profdc9/NiftyRobot/CAD/Front-Template.png

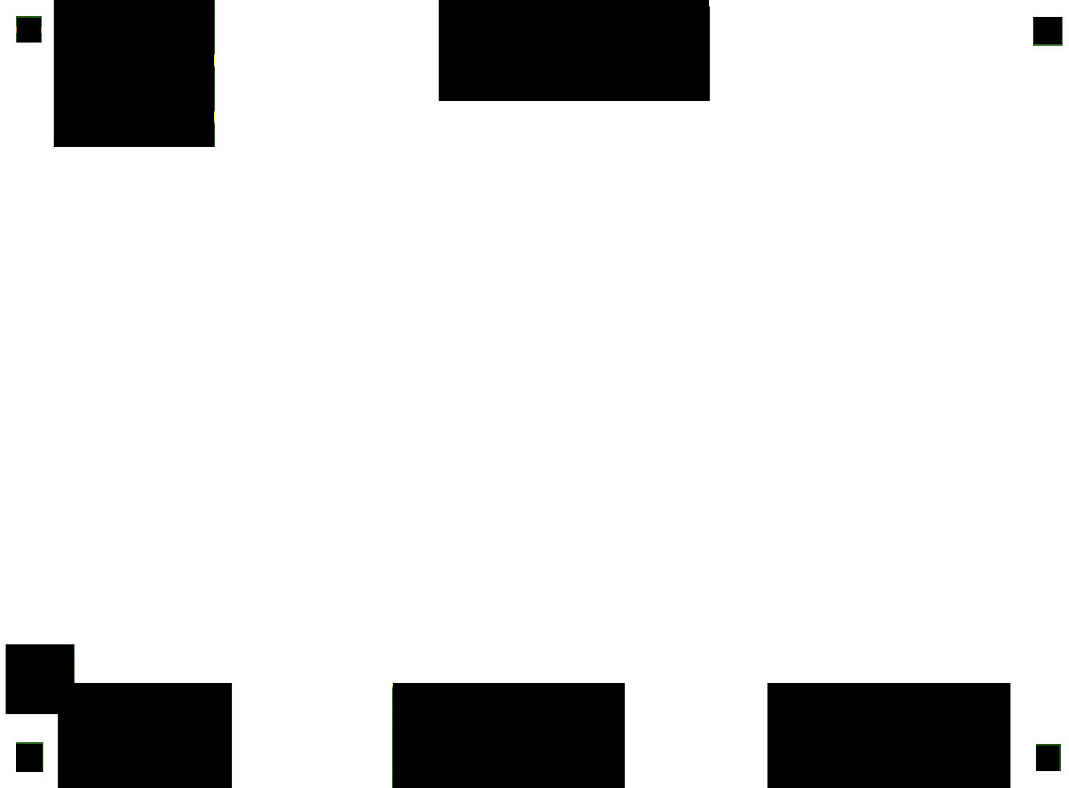
CAD/Front-Template.png
