profdc9/NiftyRobot/ControlBoard/ControlBoard-Back.png

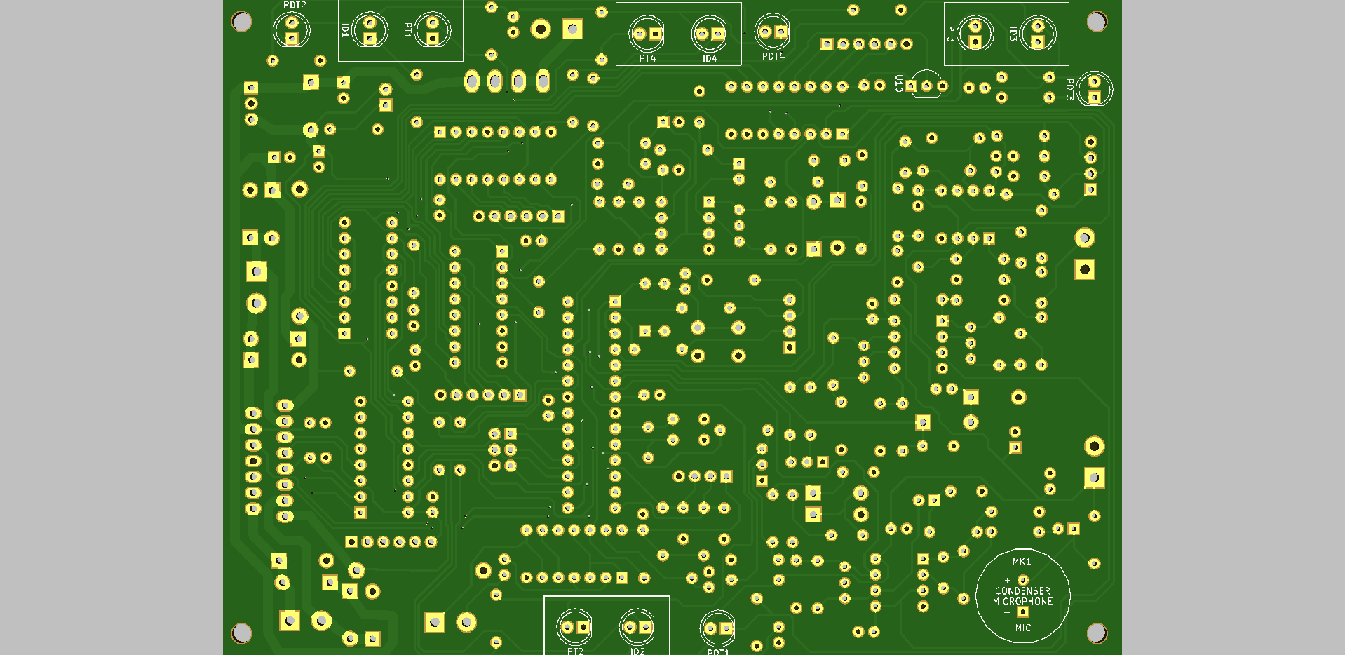
ControlBoard/ControlBoard-Back.png
