profdc9/NiftyRobot/ControlBoard/ControlBoard.png

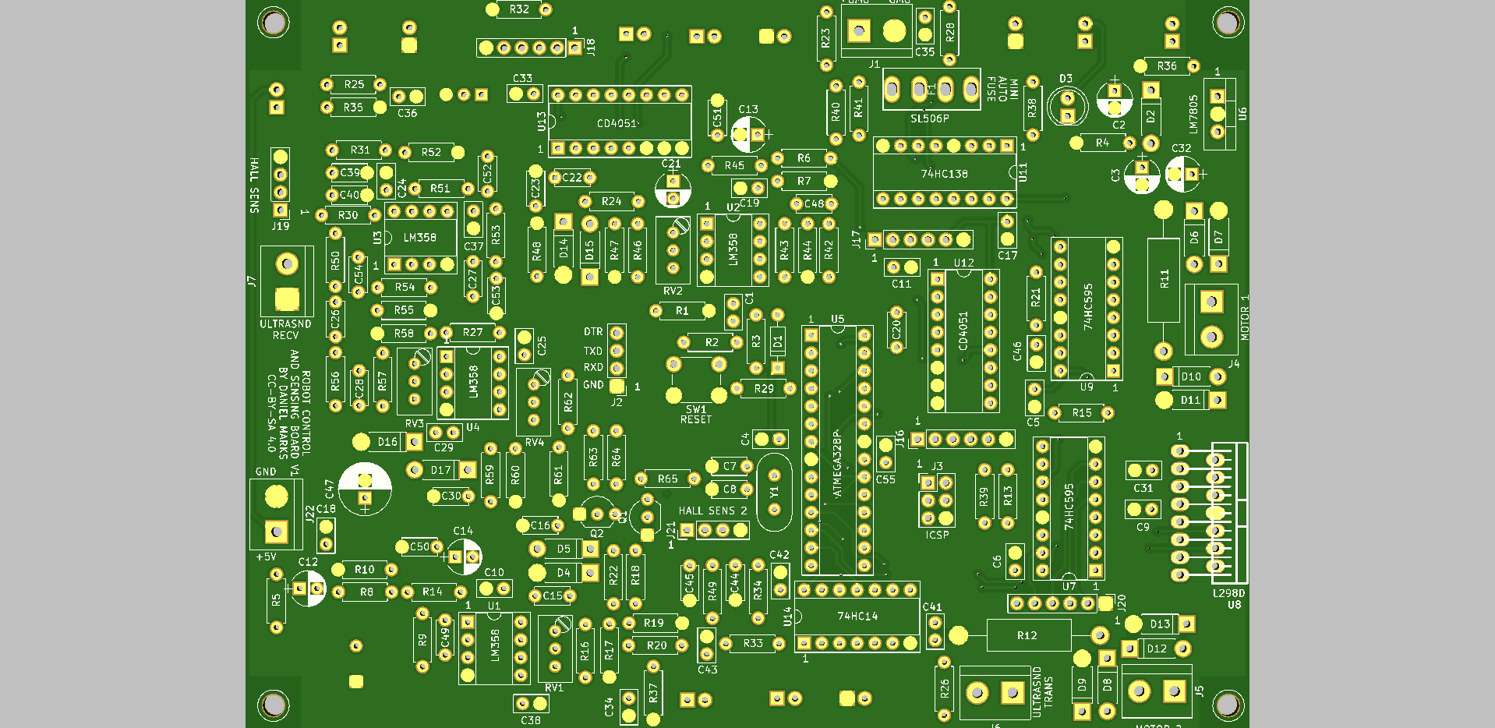
ControlBoard/ControlBoard.png
