profdc9/NiftyRobot/KeypadPI/KeypadPI-front.png

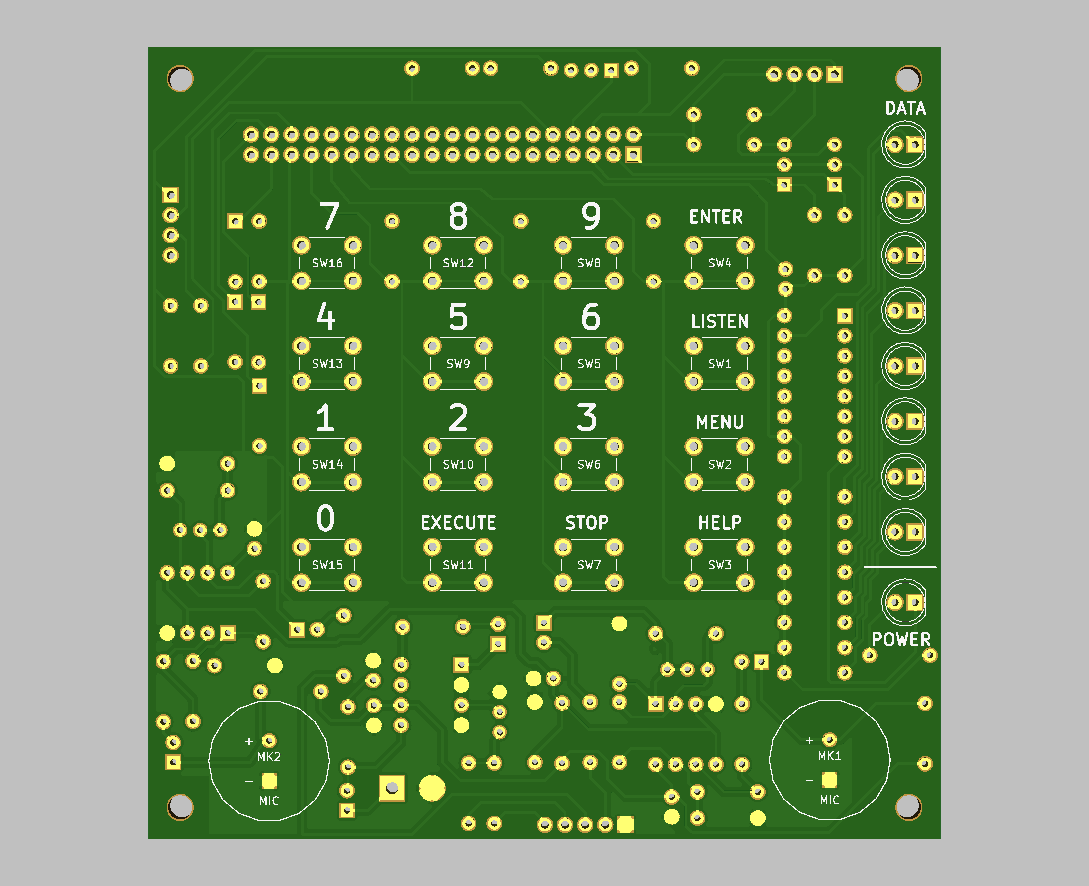
KeypadPI/KeypadPI-front.png
