profdc9/NiftyRobot/KeypadPI/KeypadPI.png

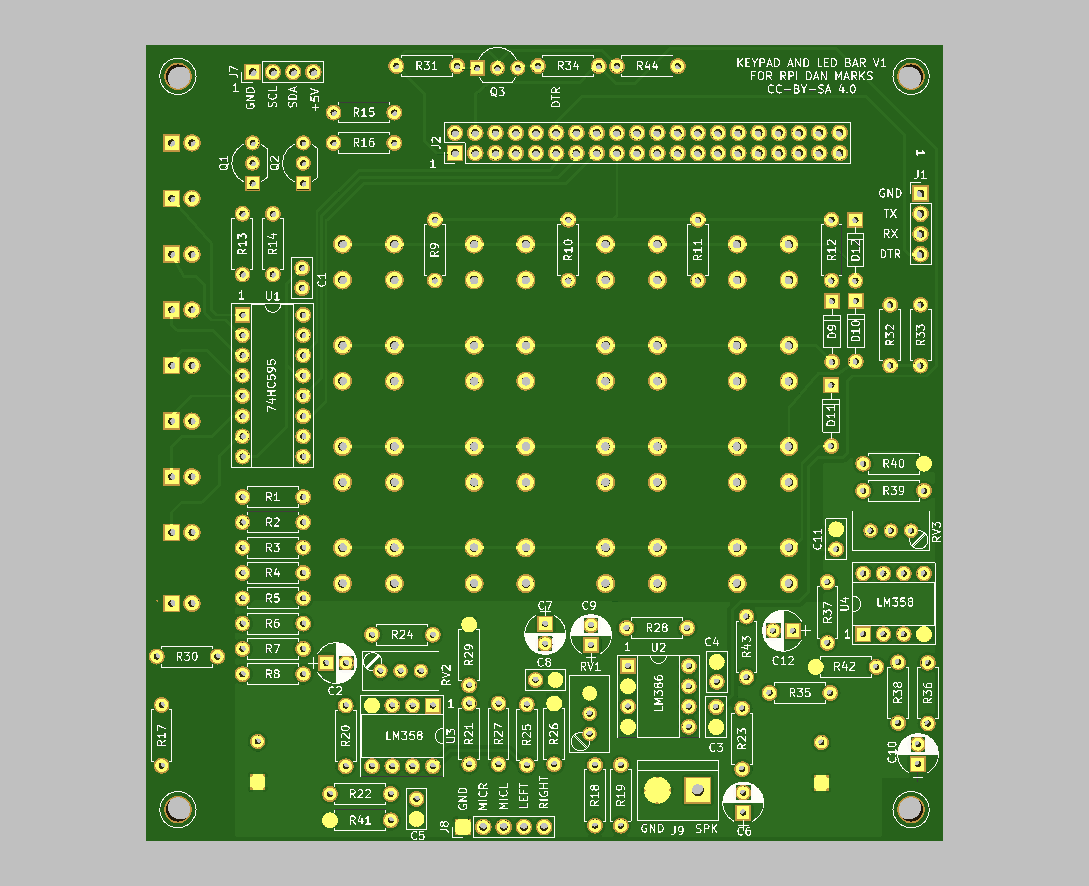
KeypadPI/KeypadPI.png
