profdc9/NiftyRobot/UltrasonicBoard/AdapterBoard.png

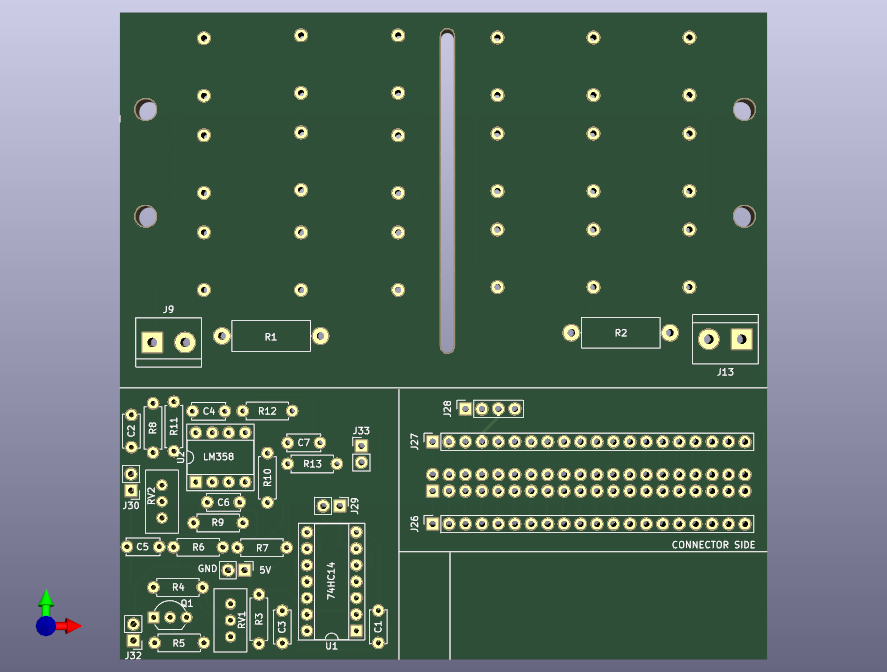
UltrasonicBoard/AdapterBoard.png
