profdc9/NiftyRobot/CAD/PCB_Bracket-TotalBracketBody.stl

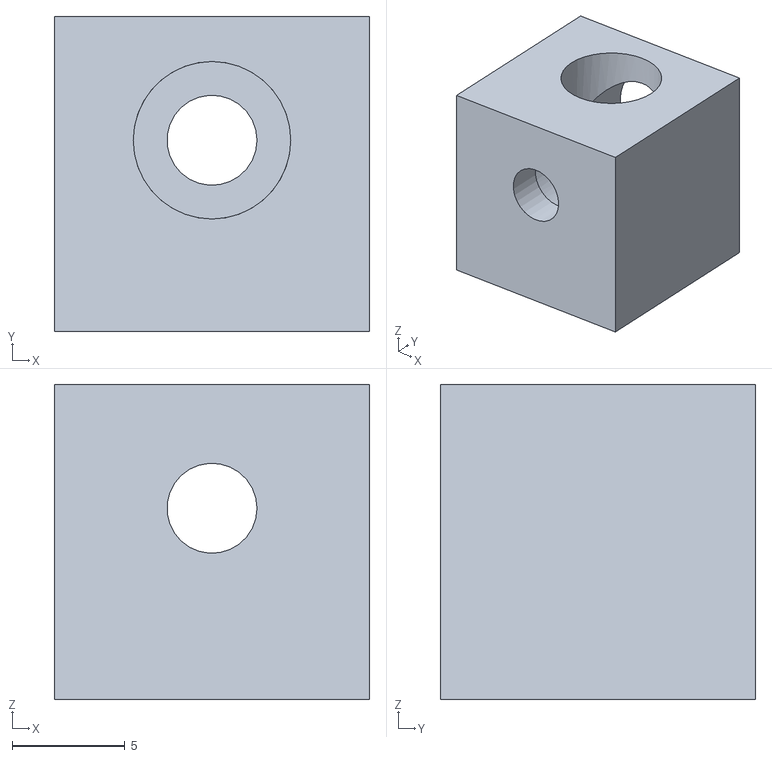
[picture p7: CAD file, 2021-11-20]
CAD/PCB_Bracket-TotalBracketBody.stl
14.0 x 14.0 x 14.0
