profdc9/NiftyRobot/CAD/Wheel-WholeWheel.stl

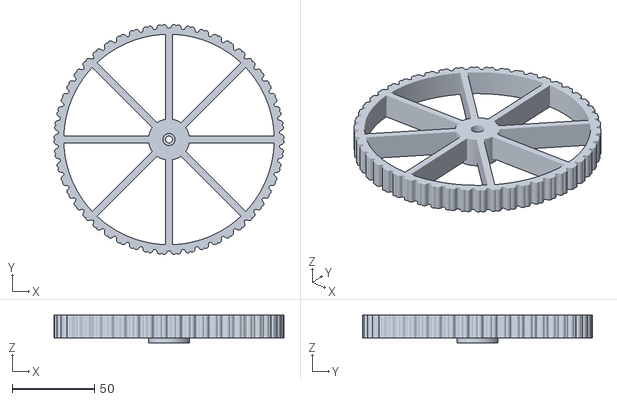
[picture p8: CAD file, 2021-11-20]
CAD/Wheel-WholeWheel.stl
139.9 x 139.8 x 17.0
