profdc9/NiftyRobot/CAD/Platform.FCStd

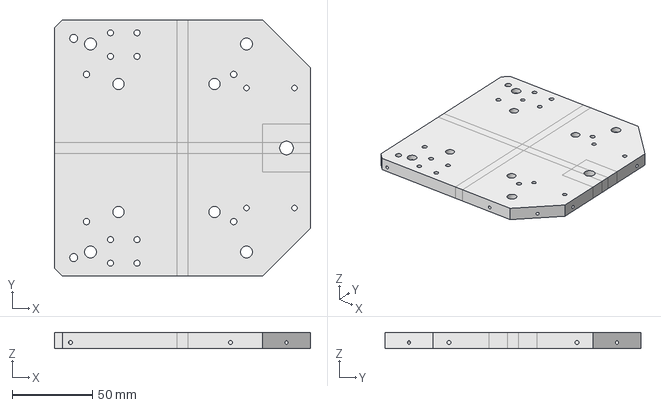
[picture p9: CAD file, 2021-11-20]
CAD/Platform.FCStd
160.0 x 160.0 x 10.0 mm
