profdc9/NiftyRobot/CAD/LeftSidePanel.FCStd

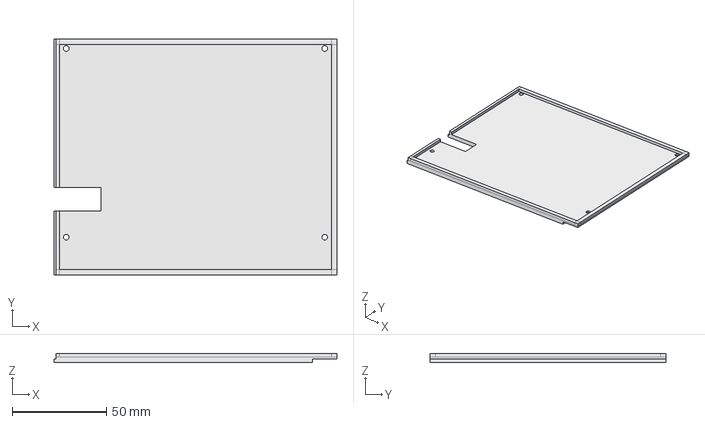
[picture p10: CAD file, 2021-11-20]
CAD/LeftSidePanel.FCStd
150.0 x 125.0 x 5.00 mm
