profdc9/NiftyRobot/CAD/FrontPanel-FrontSideBody.stl

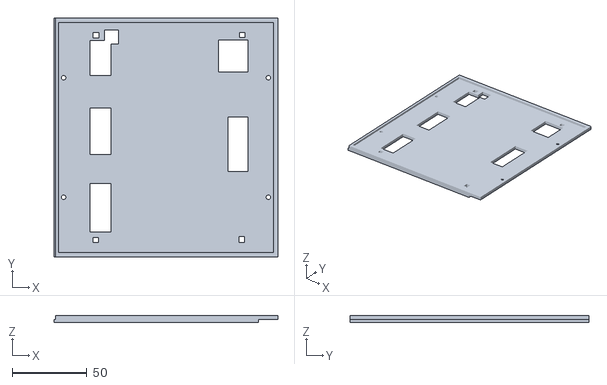
[picture p11: CAD file, 2021-10-10]
CAD/FrontPanel-FrontSideBody.stl
150.0 x 160.0 x 5.00
