profdc9/NiftyRobot/CAD/BackPanel.FCStd

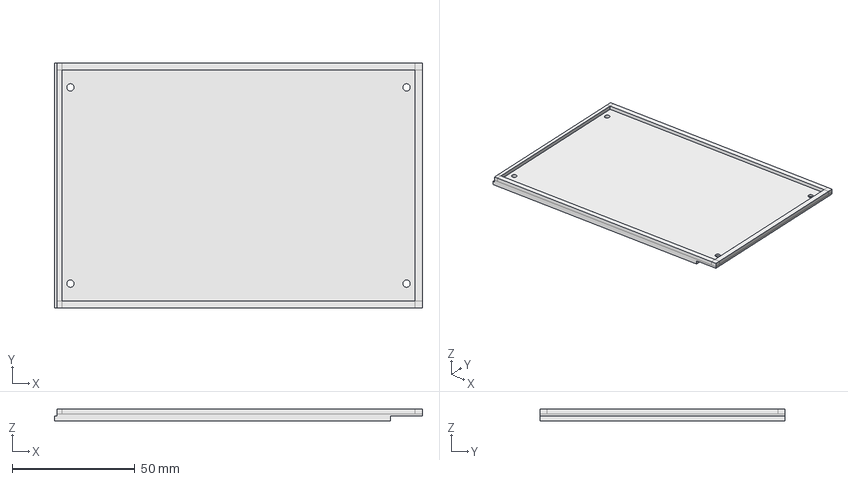
[picture p12: CAD file, 2021-10-10]
CAD/BackPanel.FCStd
150.0 x 100.0 x 5.00 mm
