profdc9/NiftyRobot/CAD/DiagonalLeftPanel-DiagonalLeftPanel.stl

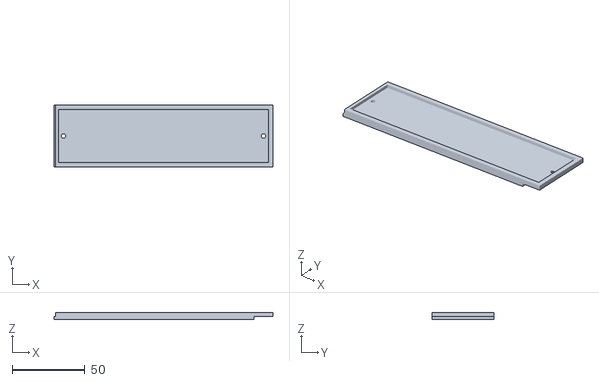
[picture p13: CAD file, 2021-10-10]
CAD/DiagonalLeftPanel-DiagonalLeftPanel.stl
150.0 x 42.4 x 5.00
