profdc9/NiftyRobot/CAD/FrontPanel2-FrontPanelTop2.stl

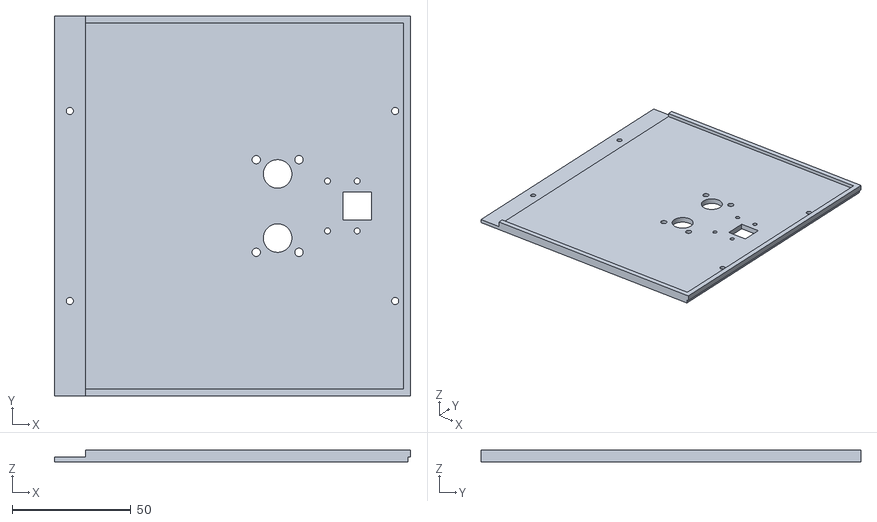
[picture p14: CAD file, 2021-10-10]
CAD/FrontPanel2-FrontPanelTop2.stl
150.0 x 160.0 x 5.00
