profdc9/NiftyRobot/CAD/RightSidePanel2.FCStd

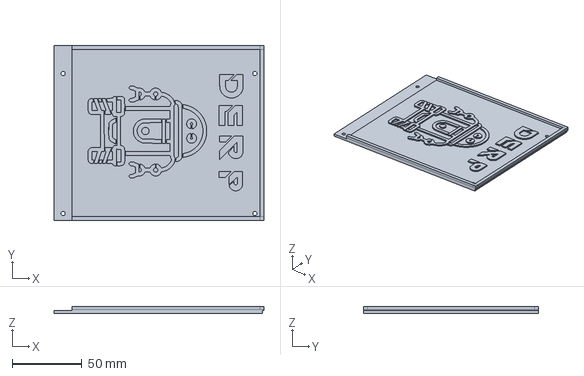
[picture p15: CAD file, 2021-10-10]
CAD/RightSidePanel2.FCStd
150.0 x 125.0 x 5.00 mm
