profdc9/NiftyRobot/CAD/FrontPanelUpper.FCStd

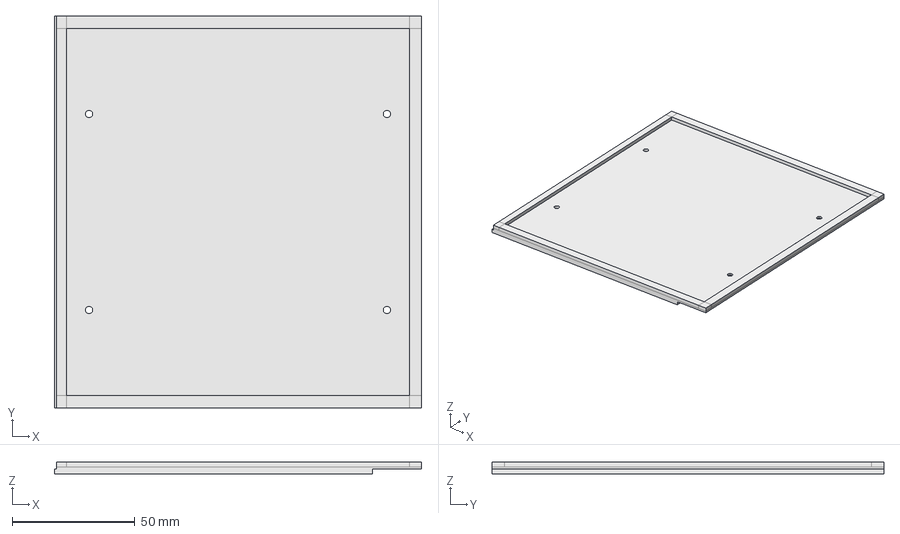
[picture p16: CAD file, 2021-10-10]
CAD/FrontPanelUpper.FCStd
150.0 x 160.0 x 5.00 mm
