profdc9/NiftyRobot/CAD/FrontPanel.FCStd

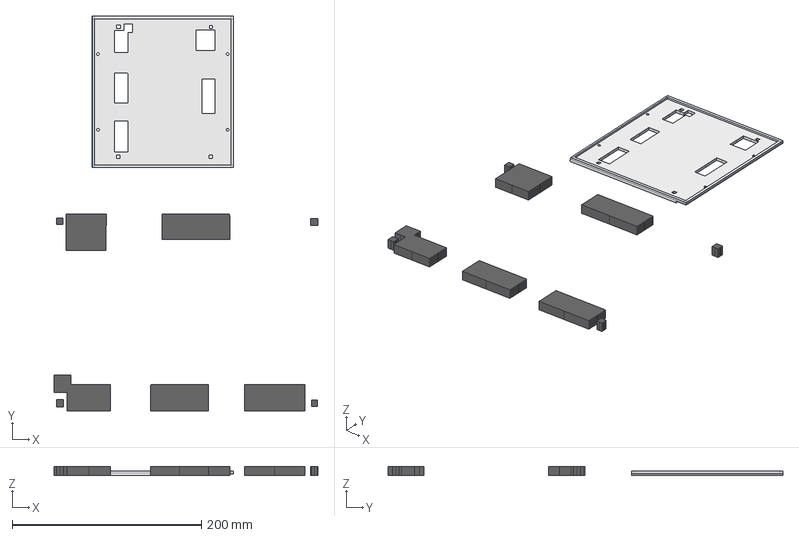
[picture p17: CAD file, 2021-10-10]
CAD/FrontPanel.FCStd
279.0 x 417.0 x 10.0 mm
HolesForBody
FrontPanelWithHoles
