profdc9/NiftyRobot/CAD/LEDPairHousingPart-UpDown.stl

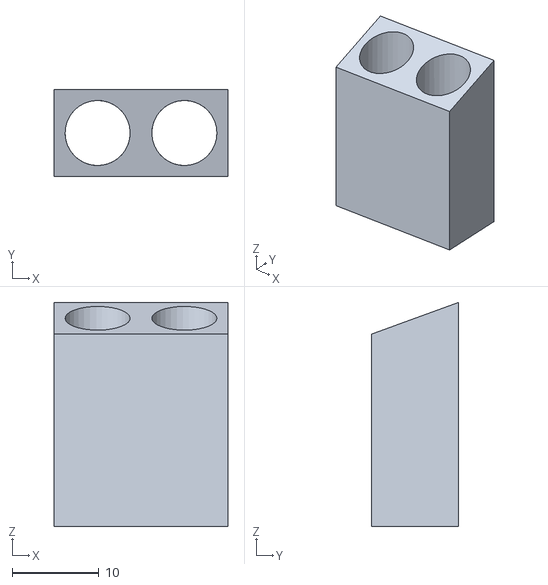
[picture p18: CAD file, 2021-09-24]
CAD/LEDPairHousingPart-UpDown.stl
20.0 x 10.0 x 25.8
