profdc9/NiftyRobot/CAD/LEDPairHousing.FCStd

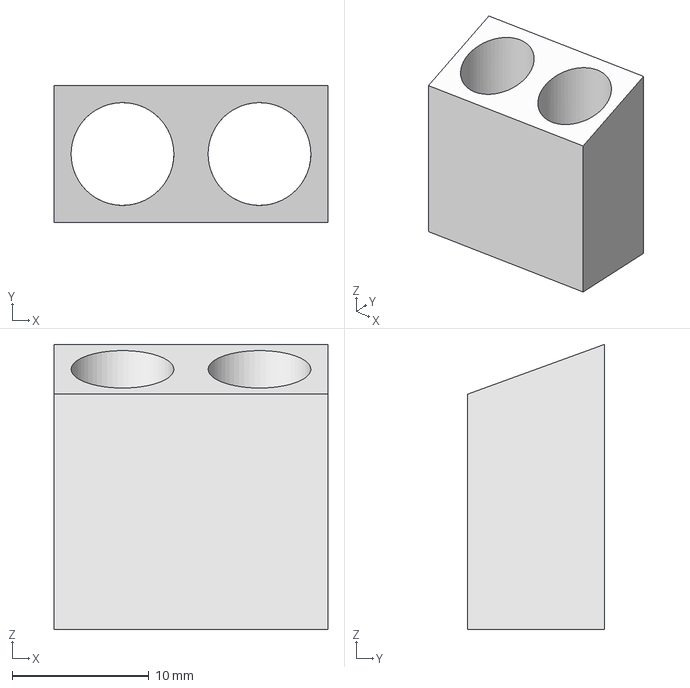
[picture p19: CAD file, 2021-09-24]
CAD/LEDPairHousing.FCStd
20.0 x 10.0 x 20.8 mm
