profdc9/NiftyRobot/CAD/LEDPairHousing-LeftRight.FCStd

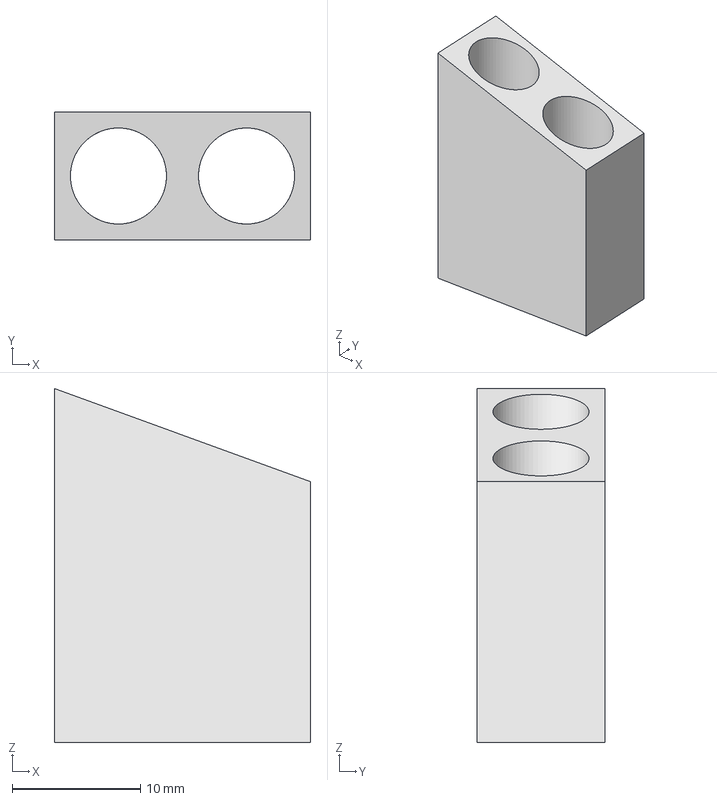
[picture p20: CAD file, 2021-09-24]
CAD/LEDPairHousing-LeftRight.FCStd
20.0 x 10.0 x 27.6 mm
