profdc9/NiftyRobot/(list of files, cad)

Other CAD files:
CAD/PCB_Bracket.FCStd
CAD/Platform-2nd3rd.FCStd
CAD/Platform-2nd3rd-RobotBase.stl
CAD/Platform-RobotBase.stl
CAD/LeftSidePanel-LeftSideBody.stl
CAD/RightSidePanel.FCStd
CAD/Wheel.FCStd
CAD/RightSidePanel-RightSideBody.stl
CAD/DiagonalLeftPanel2.stl
CAD/BackPanel2.FCStd
CAD/DiagonalRightPanel2.FCStd
CAD/BackPanel-BackPanelBody.stl
CAD/DiagonalRightPanel-DiagonalRightPanel.stl
CAD/DiagonalRightPanel.FCStd
CAD/FrontPanel2.FCStd
CAD/Platform - BeforeBase.FCStd
CAD/DiagonalLeftPanel.FCStd
CAD/LeftSidePanel2.FCStd
CAD/LEDPairHousingPart-LeftRight.stl
CAD/LEDPairHousing-UpDown.FCStd
CAD/BackPanel2.stl
CAD/DiagonalRightPanel2.stl
CAD/LeftSidePanel2.stl
CAD/RightSidePanel2.stl
