profdc9/NiftyRobot/UltrasonicBoard/AdapterBoard-Schematic.pdf

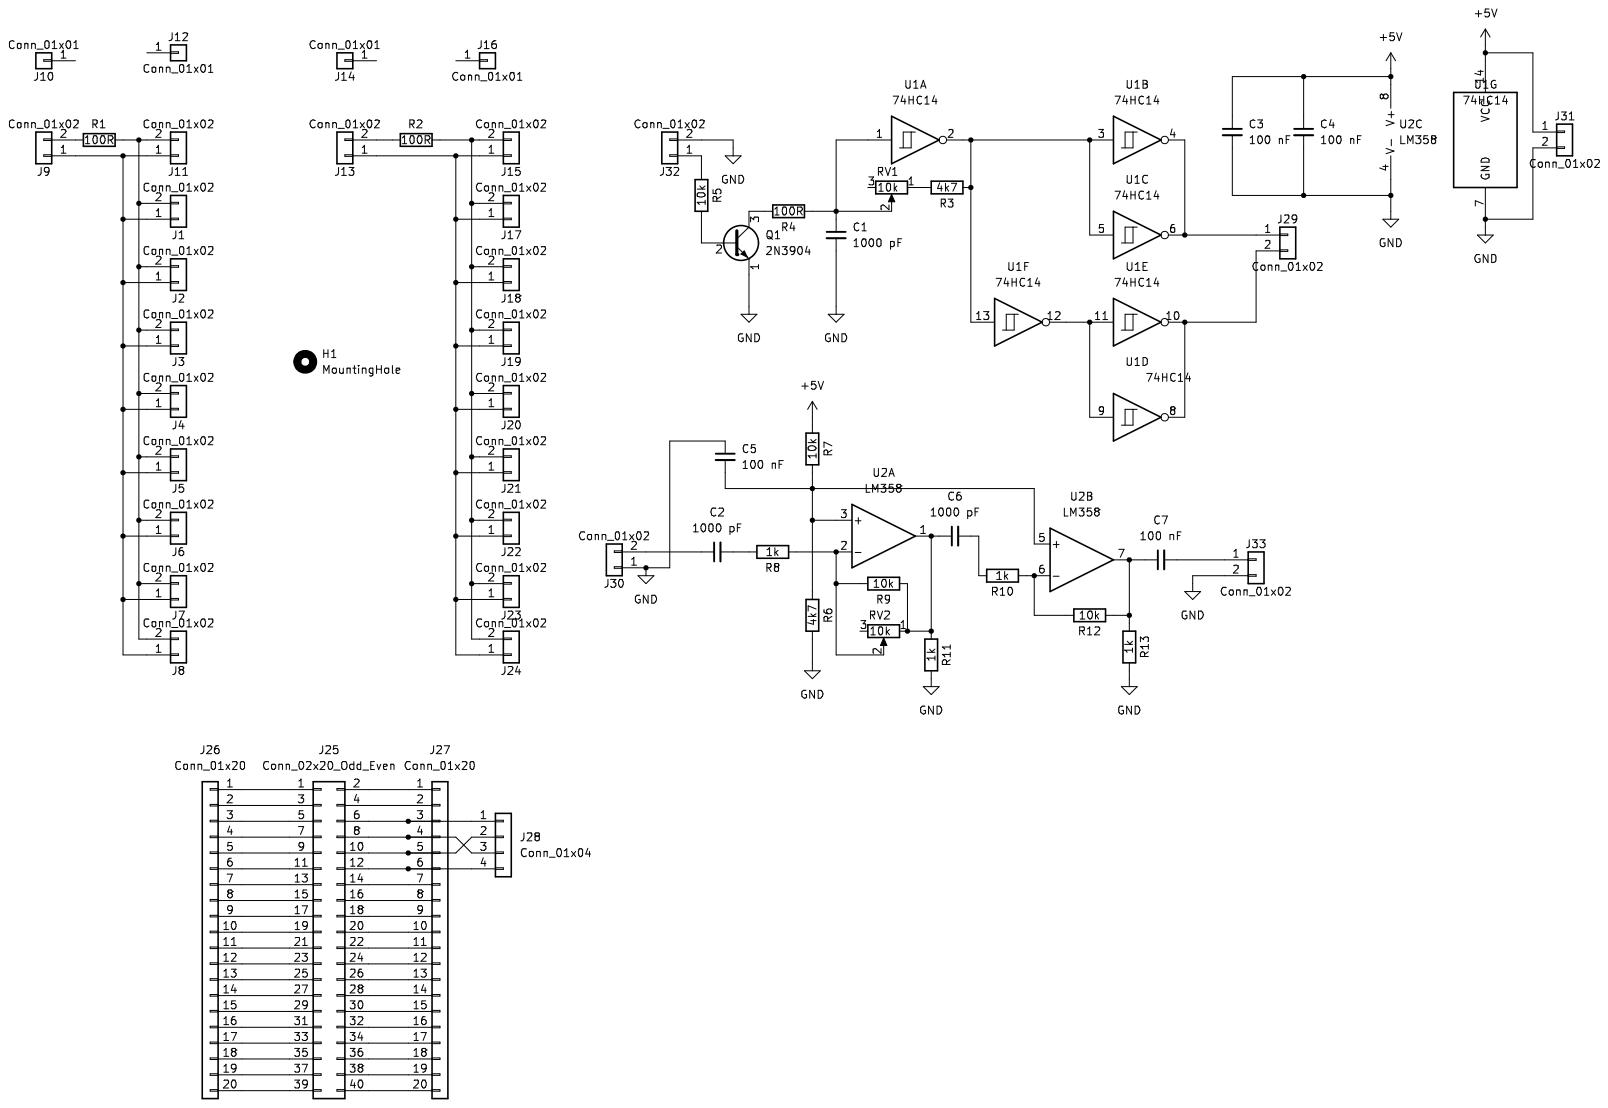
[picture p21: page 1]
