profdc9/NiftyRobot/KeypadPI/KeypadPI-schematic.pdf

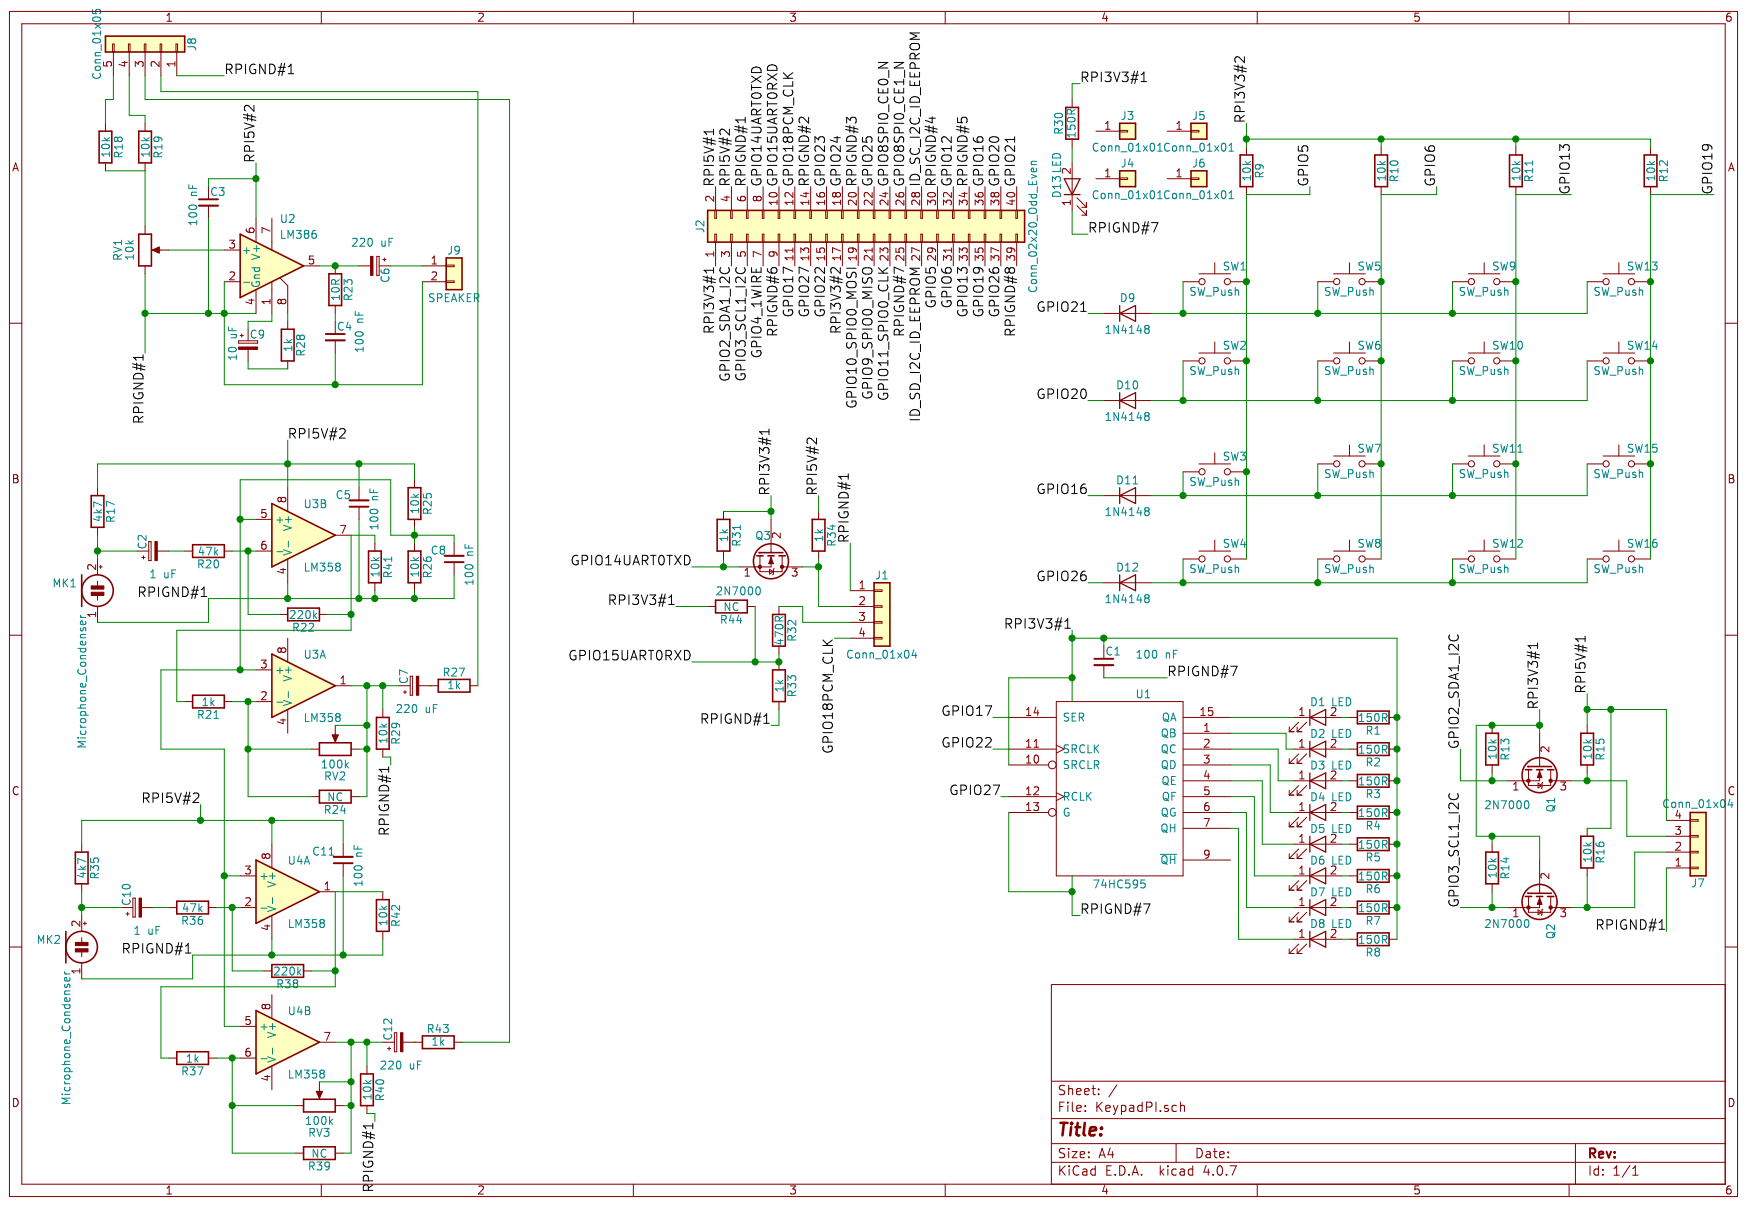
[picture p25: page 1]
