profdc9/NiftyRobot/UltrasonicBoard/AdapterBoard.kicad_pcb

## KiCad design UltrasonicBoard/AdapterBoard.kicad_pcb (2026-02-07)

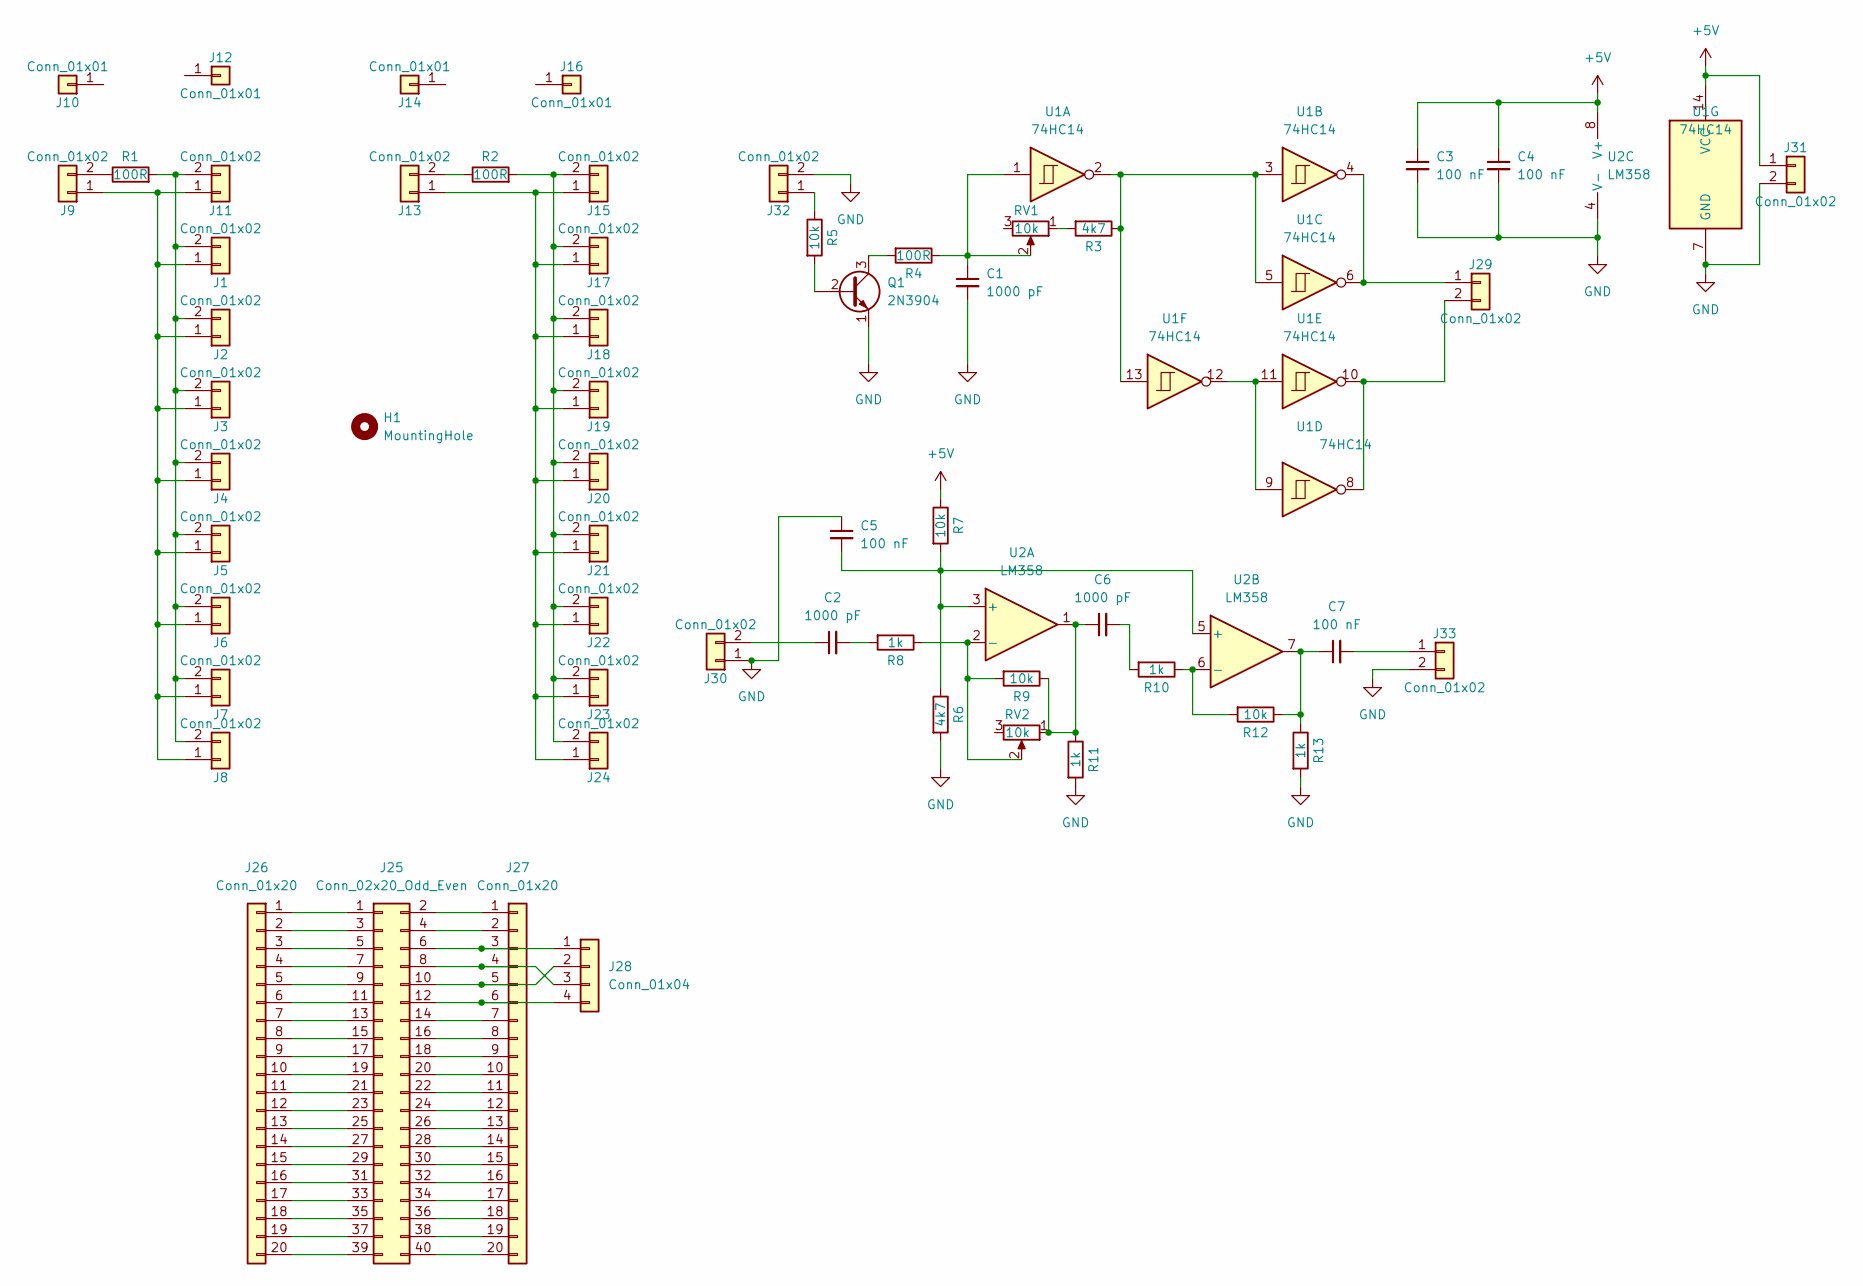
[picture p26: schematic AdapterBoard.kicad_sch]

Parts:
C1, C2, C6: 1000 pF; C_Disc_D5.0mm_W2.5mm_P5.00mm
C3, C4, C5, C7: 100 nF; C_Disc_D5.0mm_W2.5mm_P5.00mm
H1: MountingHole; BigSlotSeparator
J1, J2, J3, J4, J5, J6, J7, J8, J11, J15, J17, J18, J19, J20, J21, J22, J23, J24: Conn_01x02; UltrasoundTransceiver
J9, J13: Conn_01x02; TerminalBlock_bornier-2_P5.08mm
J10, J12, J14, J16: Conn_01x01; BlankMountingHole3.2
J25: Conn_02x20_Odd_Even; PinSocket_2x20_P2.54mm_Vertical
J26, J27: Conn_01x20; PinSocket_1x20_P2.54mm_Vertical
J28: Conn_01x04; PinSocket_1x04_P2.54mm_Vertical
J29, J30, J31, J32, J33: Conn_01x02; PinHeader_1x02_P2.54mm_Vertical
Q1: 2N3904; TO-92_Inline_Wide
R1, R2: 100R; R_Axial_DIN0414_L11.9mm_D4.5mm_P15.24mm_Horizontal
R3, R6: 4k7; R_Axial_DIN0207_L6.3mm_D2.5mm_P7.62mm_Horizontal
R4: 100R; R_Axial_DIN0207_L6.3mm_D2.5mm_P7.62mm_Horizontal
R5, R7, R9, R12: 10k; R_Axial_DIN0207_L6.3mm_D2.5mm_P7.62mm_Horizontal
R8, R10, R11, R13: 1k; R_Axial_DIN0207_L6.3mm_D2.5mm_P7.62mm_Horizontal
RV1, RV2: 10k; Potentiometer_Bourns_3296W_Vertical
U1: 74HC14; DIP-14_W7.62mm_Socket
U2: LM358; DIP-8_W7.62mm_Socket

Connections:
+5V: C3.1, C4.1, J31.1, R7.1, U1.14 (VCC), U2.8 (V+)
GND: C1.2, C3.2, C4.2, C5.1, J30.1, J31.2, J32.2, J33.2, Q1.1 (E), R6.2, R11.2, R13.2, U1.7 (GND), U2.4 (V-)
unnamed: C1.1, R4.1, RV1.2, U1.1
unnamed: C2.2, R8.2
unnamed: C6.1, R9.1, R11.1, RV2.1, U2.1
unnamed: C6.2, R10.2
unnamed: C7.1, R12.1, R13.1, U2.7
unnamed: J1.1, J2.1, J3.1, J4.1, J5.1, J6.1, J7.1, J8.1, J9.1, J11.1
unnamed: J1.2, J2.2, J3.2, J4.2, J5.2, J6.2, J7.2, J8.2, J11.2, R1.2
unnamed: J9.2, R1.1
unnamed: J13.1, J15.1, J17.1, J18.1, J19.1, J20.1, J21.1, J22.1, J23.1, J24.1
unnamed: J13.2, R2.1
unnamed: J15.2, J17.2, J18.2, J19.2, J20.2, J21.2, J22.2, J23.2, J24.2, R2.2
unnamed: J25.1, J26.1
unnamed: J25.2, J27.1
unnamed: J25.3, J26.2
unnamed: J25.4, J27.2
unnamed: J25.5, J26.3
unnamed: J25.6, J27.3, J28.1
unnamed: J25.7, J26.4
unnamed: J25.8, J27.4, J28.3
unnamed: J25.9, J26.5
unnamed: J25.10, J27.5, J28.2
unnamed: J25.11, J26.6
unnamed: J25.12, J27.6, J28.4
unnamed: J25.13, J26.7
unnamed: J25.14, J27.7
unnamed: J25.15, J26.8
unnamed: J25.16, J27.8
unnamed: J25.17, J26.9
unnamed: J25.18, J27.9
unnamed: J25.19, J26.10
unnamed: J25.20, J27.10
unnamed: J25.21, J26.11
unnamed: J25.22, J27.11
unnamed: J25.23, J26.12
unnamed: J25.24, J27.12
unnamed: J25.25, J26.13
unnamed: J25.26, J27.13
unnamed: J25.27, J26.14
unnamed: J25.28, J27.14
unnamed: J25.29, J26.15
unnamed: J25.30, J27.15
unnamed: J25.31, J26.16
unnamed: J25.32, J27.16
unnamed: J25.33, J26.17
unnamed: J25.34, J27.17
unnamed: J25.35, J26.18
unnamed: J25.36, J27.18
unnamed: J25.37, J26.19
unnamed: J25.38, J27.19
unnamed: J25.39, J26.20
unnamed: J25.40, J27.20
unnamed: J29.1, U1.4, U1.6
unnamed: J29.2, U1.8, U1.10
unnamed: C2.1, J30.2
unnamed: J32.1, R5.1
unnamed: C7.2, J33.1
unnamed: Q1.2 (B), R5.2
unnamed: Q1.3 (C), R4.2
unnamed: R3.1, U1.2, U1.3, U1.5, U1.13
unnamed: R3.2, RV1.1
unnamed: U1.9, U1.11, U1.12
unnamed: C5.2, R6.1, R7.2, U2.3 (+), U2.5 (+)
unnamed: R8.1, R9.2, RV2.2, U2.2 (-)
unnamed: R10.1, R12.2, U2.6 (-)

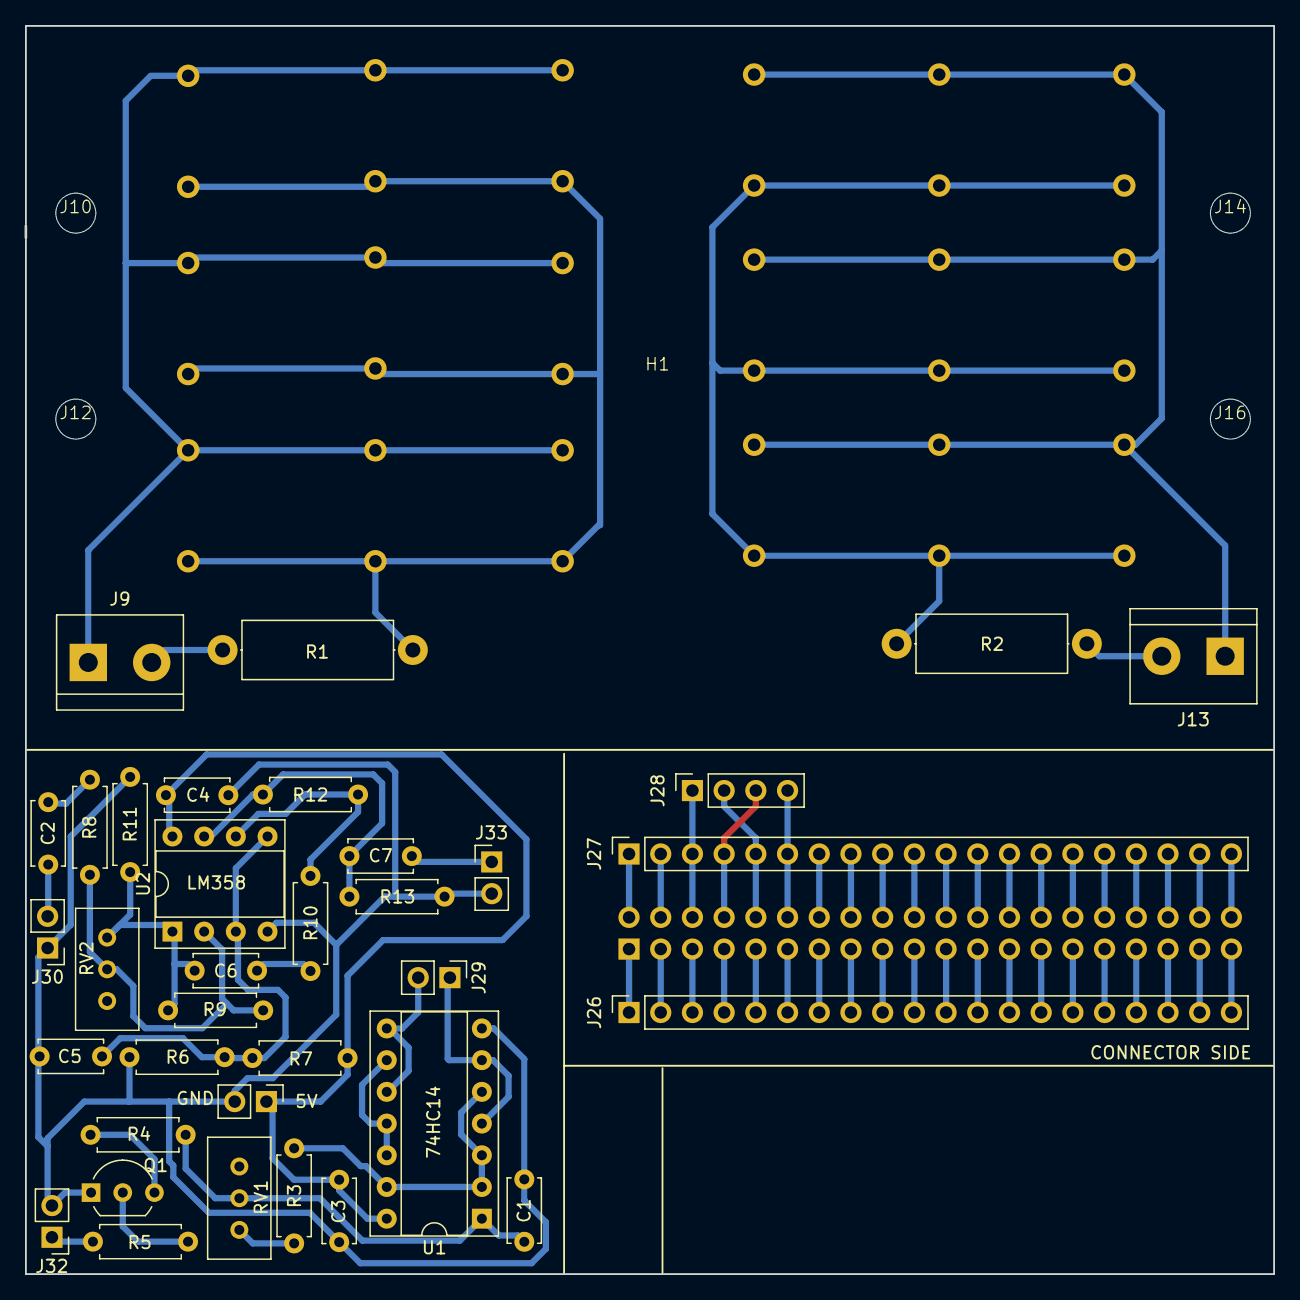
[picture p27: board UltrasonicBoard/AdapterBoard.kicad_pcb from above]

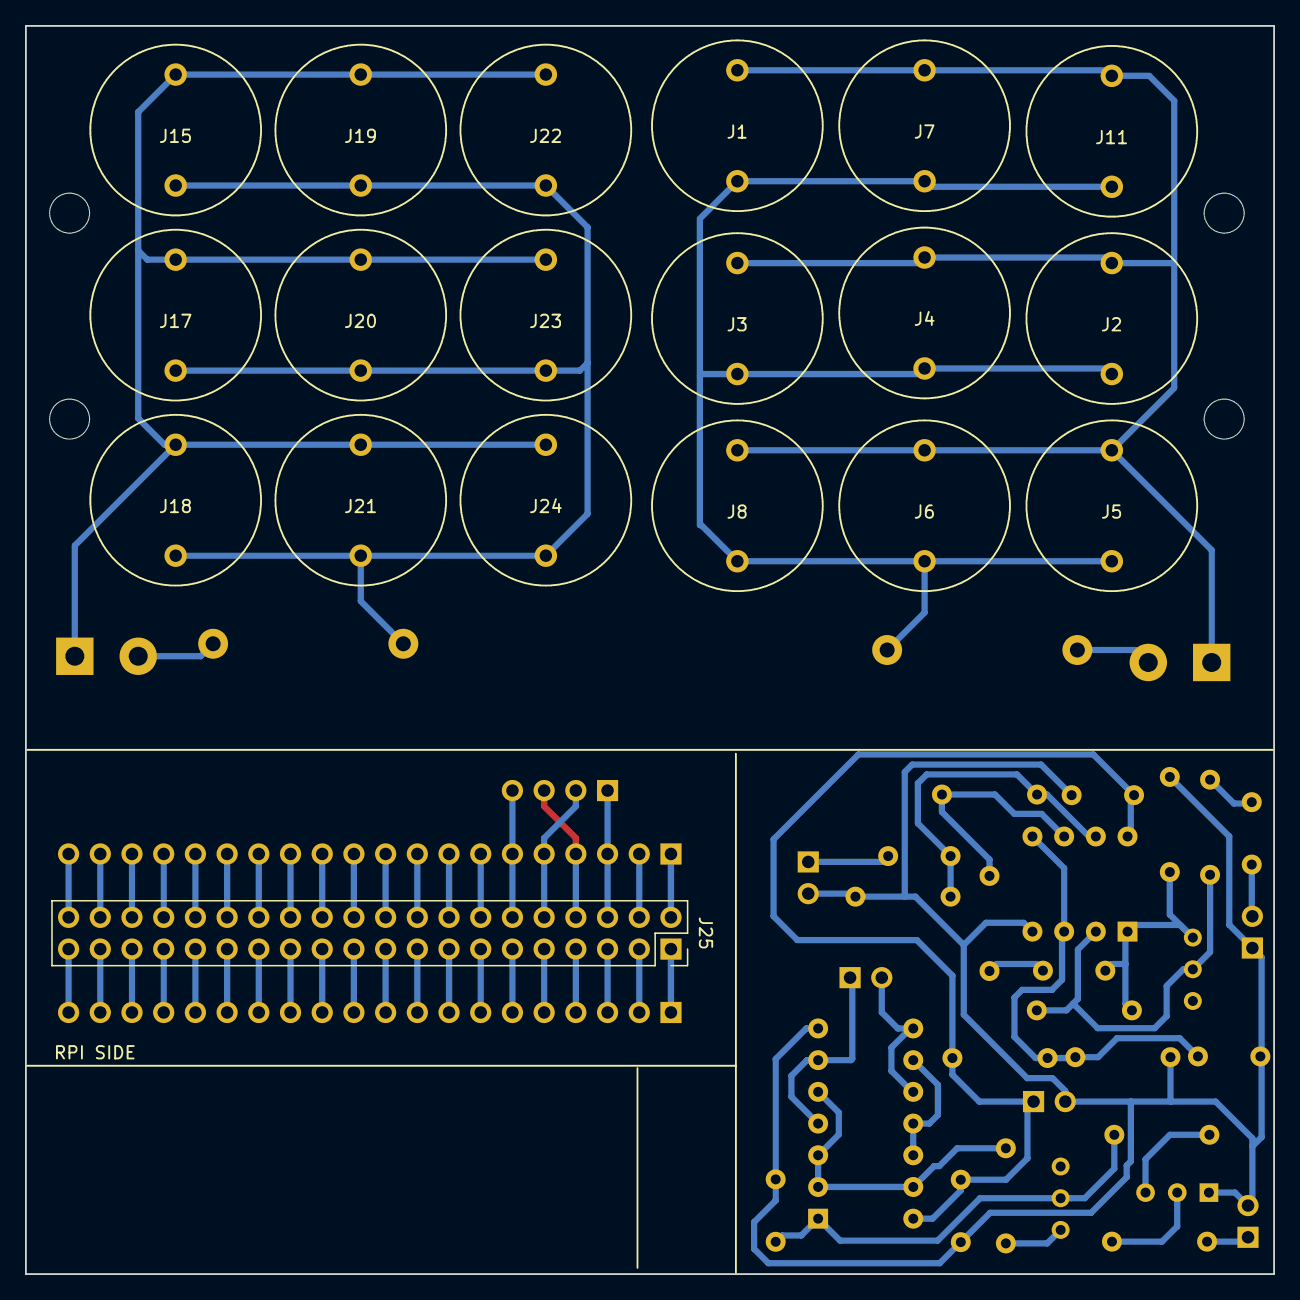
[picture p28: board UltrasonicBoard/AdapterBoard.kicad_pcb from below]

Board: 2 copper layers, 100.0 x 100.0 mm, 59 parts (19 on the bottom side), 66 nets.
