profdc9/NiftyRobot/AdapterBoard/AdapterBoard.kicad_pcb

## KiCad design AdapterBoard/AdapterBoard.kicad_pcb (2025-10-23, an earlier design)

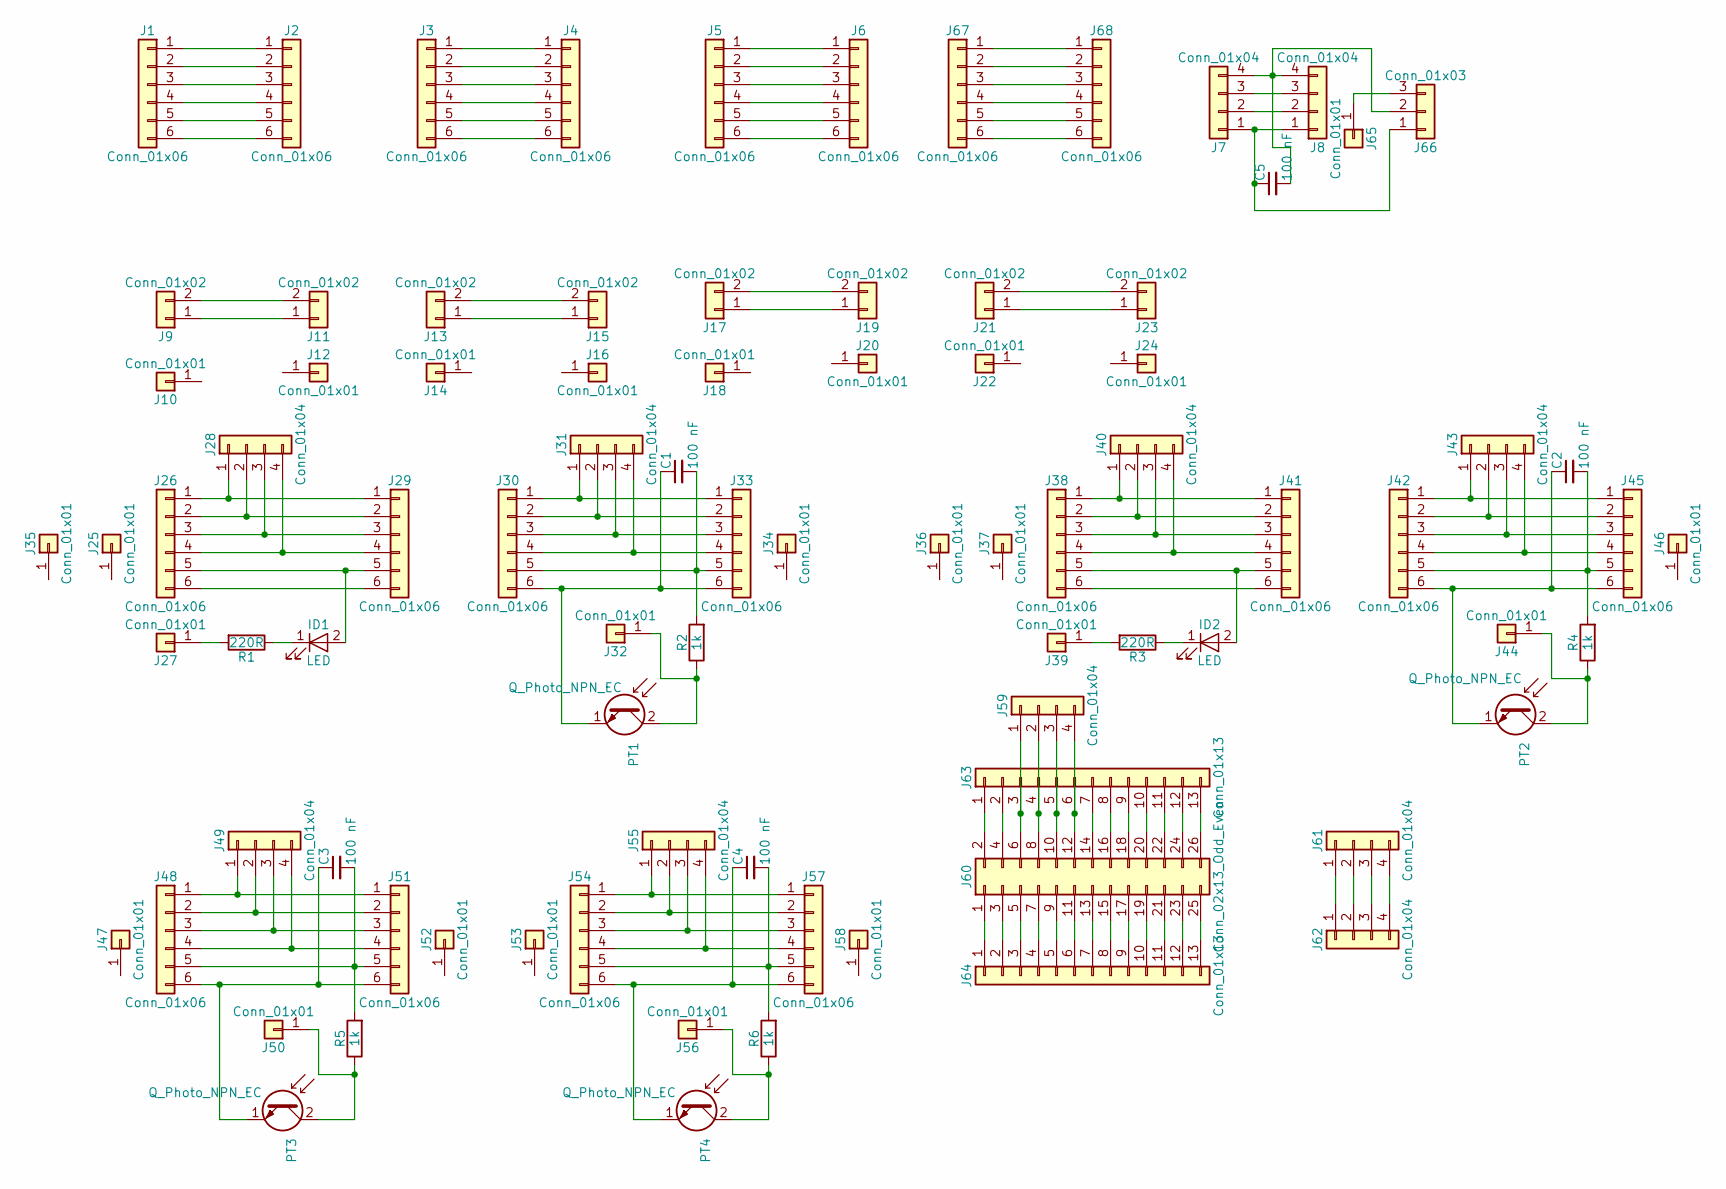
[picture p29: schematic AdapterBoard.kicad_sch]

Parts:
C1, C2, C3, C4, C5: 100 nF; C_Disc_D5.0mm_W2.5mm_P2.50mm
ID1, ID2: LED; LED_D5.0mm
J1, J2, J3, J4, J5, J6, J26, J29, J30, J33, J38, J41, J42, J45, J48, J51, J54, J57, J67, J68: Conn_01x06; Pin_Header_Straight_1x06_Pitch2.54mm
J7, J8, J28, J31, J40, J43, J49, J55, J59, J61, J62: Conn_01x04; Pin_Header_Straight_1x04_Pitch2.54mm
J9, J13, J17, J21: Conn_01x02; TerminalBlock_bornier-2_P5.08mm
J10, J12, J14, J16, J18, J20, J22, J24, J25, J34, J37, J46, J47, J52, J53, J58: Conn_01x01; 1pin
J11, J15, J19, J23: Conn_01x02; UltrasoundTransceiver
J27, J32, J39, J44, J50, J56, J65: Conn_01x01; Pin_Header_Straight_1x01_Pitch2.54mm
J35, J36: Conn_01x01; IRPair
J60: Conn_02x13_Odd_Even; Pin_Header_Straight_2x13_Pitch2.54mm
J63, J64: Conn_01x13; Pin_Header_Straight_1x13_Pitch2.54mm
J66: Conn_01x03; TO-92_Inline_Wide
PT1, PT2, PT3, PT4: Q_Photo_NPN_EC; LED_D5.0mm
R1, R3: 220R; R_Axial_DIN0207_L6.3mm_D2.5mm_P7.62mm_Horizontal
R2, R4, R5, R6: 1k; R_Axial_DIN0207_L6.3mm_D2.5mm_P7.62mm_Horizontal

Connections:
unnamed: C1.1, J30.6, J33.6, PT1.1 (E)
unnamed: C1.2, J30.5, J33.5, R2.2
unnamed: C2.1, J42.6, J45.6, PT2.1 (E)
unnamed: C2.2, J42.5, J45.5, R4.2
unnamed: C3.1, J48.6, J51.6, PT3.1 (E)
unnamed: C3.2, J48.5, J51.5, R5.2
unnamed: C4.1, J54.6, J57.6, PT4.1 (E)
unnamed: C4.2, J54.5, J57.5, R6.2
unnamed: C5.1, J7.1, J8.1, J66.1
unnamed: C5.2, J7.4, J8.4, J66.2
unnamed: ID1.1 (K), R1.1
unnamed: ID1.2 (A), J26.5, J29.5
unnamed: ID2.1 (K), R3.1
unnamed: ID2.2 (A), J38.5, J41.5
unnamed: J1.1, J2.1
unnamed: J1.2, J2.2
unnamed: J1.3, J2.3
unnamed: J1.4, J2.4
unnamed: J1.5, J2.5
unnamed: J1.6, J2.6
unnamed: J3.1, J4.1
unnamed: J3.2, J4.2
unnamed: J3.3, J4.3
unnamed: J3.4, J4.4
unnamed: J3.5, J4.5
unnamed: J3.6, J4.6
unnamed: J5.1, J6.1
unnamed: J5.2, J6.2
unnamed: J5.3, J6.3
unnamed: J5.4, J6.4
unnamed: J5.5, J6.5
unnamed: J5.6, J6.6
unnamed: J7.2, J8.2
unnamed: J7.3, J8.3
unnamed: J9.1, J11.1
unnamed: J9.2, J11.2
unnamed: J13.1, J15.1
unnamed: J13.2, J15.2
unnamed: J17.1, J19.1
unnamed: J17.2, J19.2
unnamed: J21.1, J23.1
unnamed: J21.2, J23.2
unnamed: J26.1, J28.1, J29.1
unnamed: J26.2, J28.2, J29.2
unnamed: J26.3, J28.3, J29.3
unnamed: J26.4, J28.4, J29.4
unnamed: J26.6, J29.6
unnamed: J27.1, R1.2
unnamed: J30.1, J31.1, J33.1
unnamed: J30.2, J31.2, J33.2
unnamed: J30.3, J31.3, J33.3
unnamed: J30.4, J31.4, J33.4
unnamed: J32.1, PT1.2 (C), R2.1
unnamed: J38.1, J40.1, J41.1
unnamed: J38.2, J40.2, J41.2
unnamed: J38.3, J40.3, J41.3
unnamed: J38.4, J40.4, J41.4
unnamed: J38.6, J41.6
unnamed: J39.1, R3.2
unnamed: J42.1, J43.1, J45.1
unnamed: J42.2, J43.2, J45.2
unnamed: J42.3, J43.3, J45.3
unnamed: J42.4, J43.4, J45.4
unnamed: J44.1, PT2.2 (C), R4.1
unnamed: J48.1, J49.1, J51.1
unnamed: J48.2, J49.2, J51.2
unnamed: J48.3, J49.3, J51.3
unnamed: J48.4, J49.4, J51.4
unnamed: J50.1, PT3.2 (C), R5.1
unnamed: J54.1, J55.1, J57.1
unnamed: J54.2, J55.2, J57.2
unnamed: J54.3, J55.3, J57.3
unnamed: J54.4, J55.4, J57.4
unnamed: J56.1, PT4.2 (C), R6.1
unnamed: J59.1, J60.6, J63.3
unnamed: J59.2, J60.8, J63.4
unnamed: J59.3, J60.10, J63.5
unnamed: J59.4, J60.12, J63.6
unnamed: J60.1, J64.1
unnamed: J60.2, J63.1
unnamed: J60.3, J64.2
unnamed: J60.4, J63.2
unnamed: J60.5, J64.3
unnamed: J60.7, J64.4
unnamed: J60.9, J64.5
unnamed: J60.11, J64.6
unnamed: J60.13, J64.7
unnamed: J60.14, J63.7
unnamed: J60.15, J64.8
unnamed: J60.16, J63.8
unnamed: J60.17, J64.9
unnamed: J60.18, J63.9
unnamed: J60.19, J64.10
unnamed: J60.20, J63.10
unnamed: J60.21, J64.11
unnamed: J60.22, J63.11
unnamed: J60.23, J64.12
unnamed: J60.24, J63.12
unnamed: J60.25, J64.13
unnamed: J60.26, J63.13
unnamed: J61.1, J62.1
unnamed: J61.2, J62.2
unnamed: J61.3, J62.3
unnamed: J61.4, J62.4
unnamed: J65.1, J66.3
unnamed: J67.1, J68.1
unnamed: J67.2, J68.2
unnamed: J67.3, J68.3
unnamed: J67.4, J68.4
unnamed: J67.5, J68.5
unnamed: J67.6, J68.6

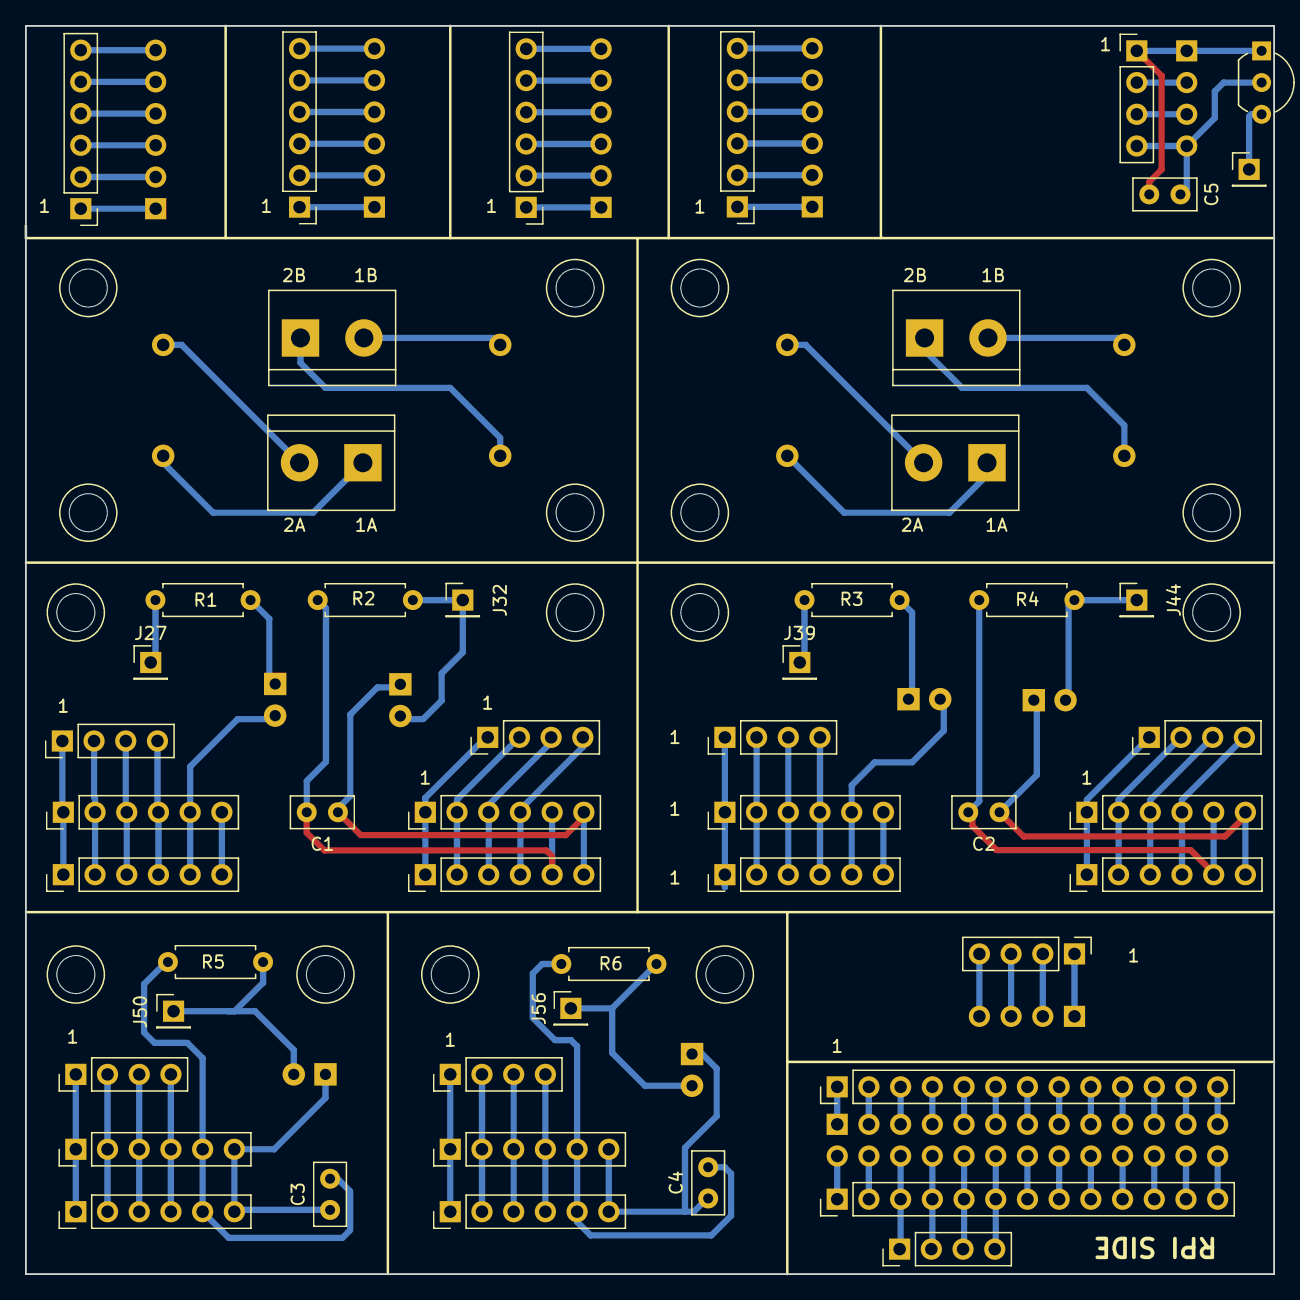
[picture p30: board AdapterBoard/AdapterBoard.kicad_pcb from above]

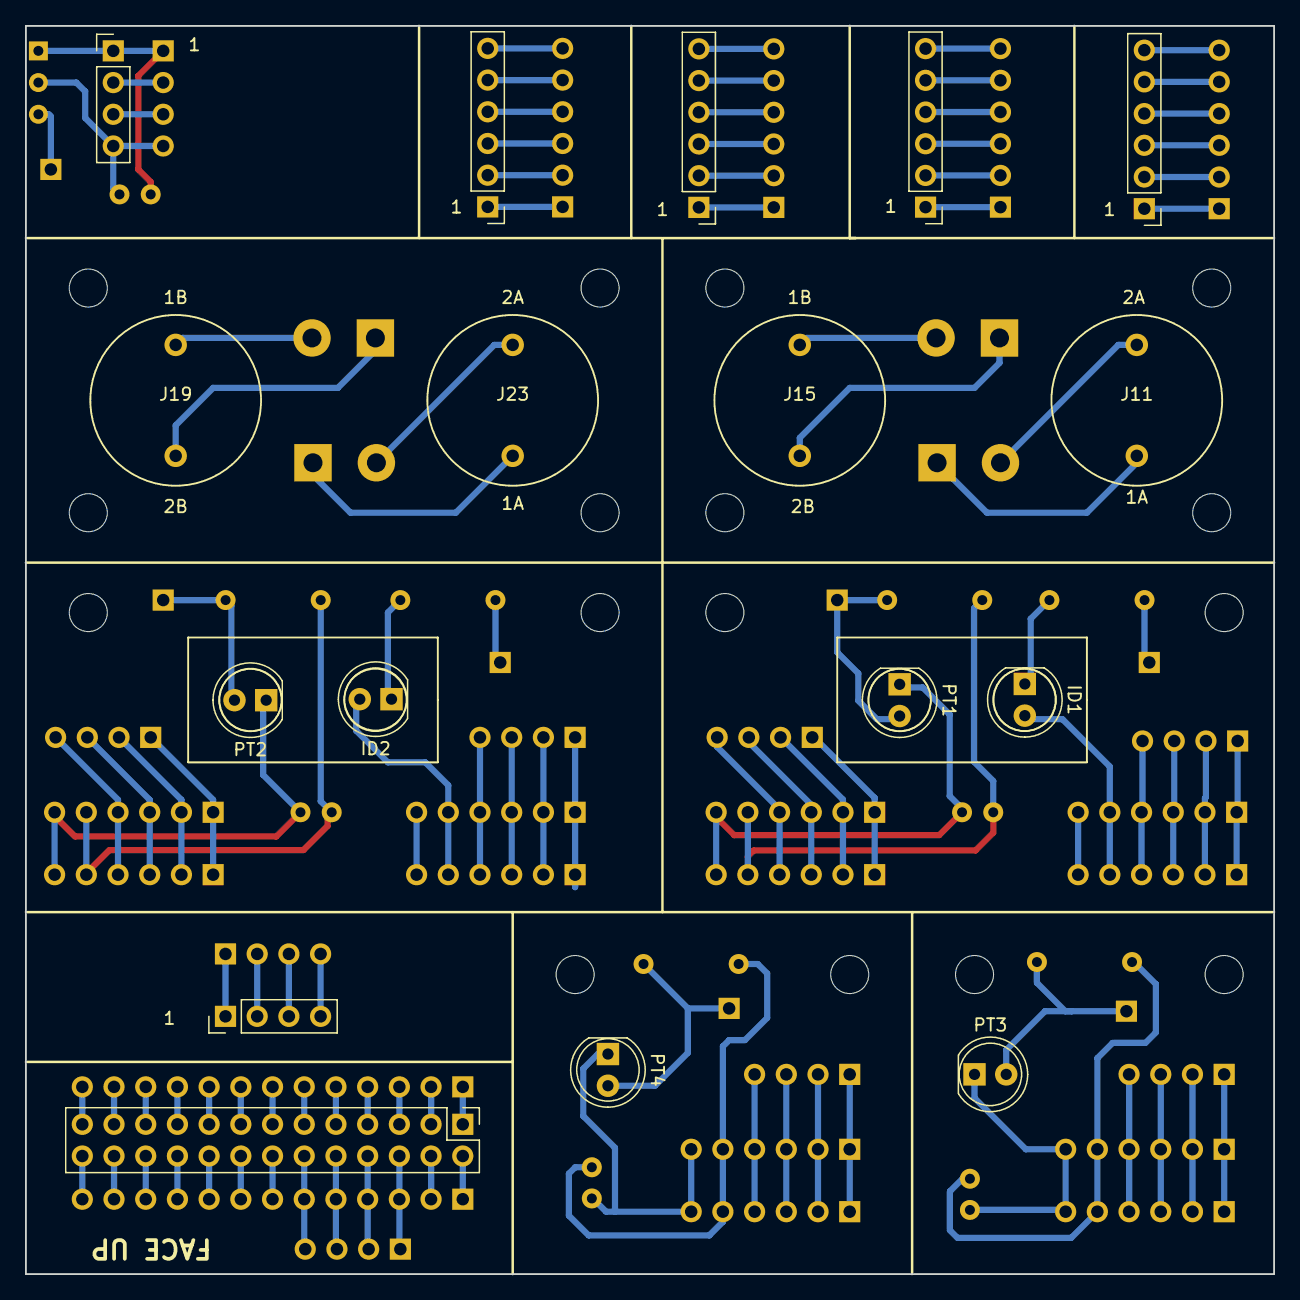
[picture p31: board AdapterBoard/AdapterBoard.kicad_pcb from below]

Board: 2 copper layers, 100.0 x 100.0 mm, 85 parts (19 on the bottom side), 111 nets.
