profdc9/NiftyRobot/ControlBoard/ControlBoard.kicad_pcb

## KiCad design ControlBoard/ControlBoard.kicad_pcb (2025-10-23)

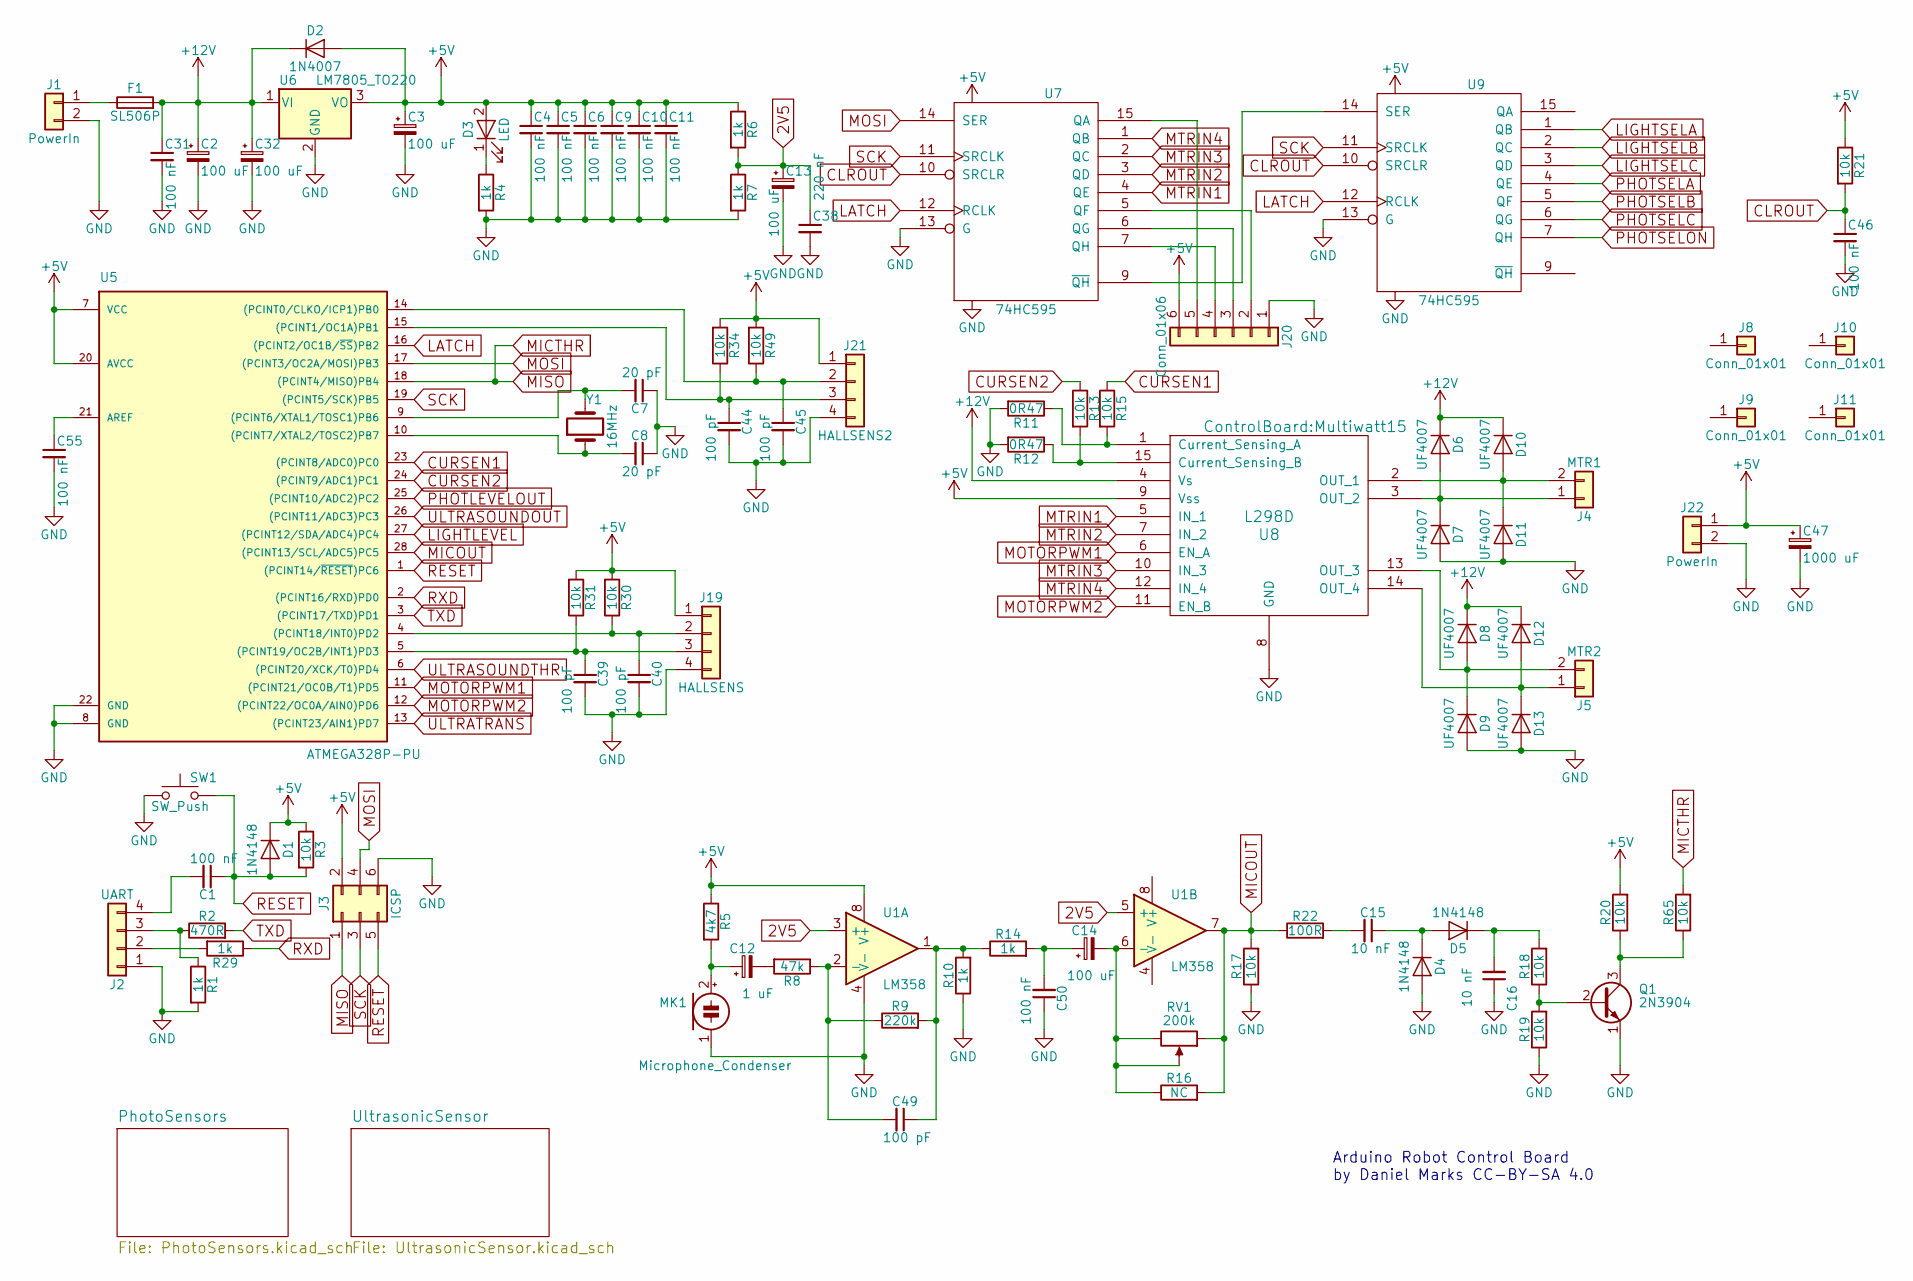
[picture p32: schematic ControlBoard.kicad_sch]

Parts:
C1, C4, C5, C6, C9, C10, C11, C31, C46, C55: 100 nF; C_Disc_D5.0mm_W2.5mm_P2.50mm
C2, C3, C13, C14, C32: 100 uF; CP_Radial_D5.0mm_P2.50mm
C7, C8: 20 pF; C_Disc_D5.0mm_W2.5mm_P5.00mm
C12: 1 uF; CP_Radial_D5.0mm_P2.50mm
C15, C16: 10 nF; C_Disc_D5.0mm_W2.5mm_P5.00mm
C38: 220 nF; C_Disc_D5.0mm_W2.5mm_P2.50mm
C39, C40, C44, C45, C49: 100 pF; C_Disc_D5.0mm_W2.5mm_P5.00mm
C47: 1000 uF; CP_Radial_D7.5mm_P2.50mm
C50: 100 nF; C_Disc_D5.0mm_W2.5mm_P5.00mm
D1: 1N4148; D_DO-35_SOD27_P7.62mm_Horizontal
D2: 1N4007; D_DO-41_SOD81_P7.62mm_Horizontal
D3: LED; LED_D5.0mm
D4, D5: 1N4148; D_DO-41_SOD81_P7.62mm_Horizontal
D6, D7, D8, D9, D10, D11, D12, D13: UF4007; D_DO-41_SOD81_P7.62mm_Horizontal
F1: SL506P; SL506Pfuseholder
J1, J22: PowerIn; TerminalBlock_bornier-2_P5.08mm
J2: UART; Pin_Header_Straight_1x04_Pitch2.54mm
J3: ICSP; Pin_Header_Straight_2x03_Pitch2.54mm
J4: MTR1; TerminalBlock_bornier-2_P5.08mm
J5: MTR2; TerminalBlock_bornier-2_P5.08mm
J8, J9, J10, J11: Conn_01x01; 1pin
J19: HALLSENS; Pin_Header_Straight_1x04_Pitch2.54mm
J20: Conn_01x06; Pin_Header_Straight_1x06_Pitch2.54mm
J21: HALLSENS2; Pin_Header_Straight_1x04_Pitch2.54mm
MK1: Microphone_Condenser; CondenserMic
Q1: 2N3904; TO-92_Inline_Wide
R1, R4, R6, R7, R10, R14, R29: 1k; R_Axial_DIN0207_L6.3mm_D2.5mm_P7.62mm_Horizontal
R2: 470R; R_Axial_DIN0207_L6.3mm_D2.5mm_P7.62mm_Horizontal
R3, R13, R15, R17, R18, R19, R20, R21, R30, R31, R34, R49, R65: 10k; R_Axial_DIN0207_L6.3mm_D2.5mm_P7.62mm_Horizontal
R5: 4k7; R_Axial_DIN0207_L6.3mm_D2.5mm_P7.62mm_Horizontal
R8: 47k; R_Axial_DIN0207_L6.3mm_D2.5mm_P7.62mm_Horizontal
R9: 220k; R_Axial_DIN0207_L6.3mm_D2.5mm_P7.62mm_Horizontal
R11, R12: 0R47; R_Axial_DIN0414_L11.9mm_D4.5mm_P20.32mm_Horizontal
R16: NC; R_Axial_DIN0207_L6.3mm_D2.5mm_P7.62mm_Horizontal
R22: 100R; R_Axial_DIN0207_L6.3mm_D2.5mm_P7.62mm_Horizontal
RV1: 200k; Potentiometer_Trimmer_Bourns_3296W
SW1: SW_Push; SW_PUSH_6mm
U1: LM358; DIP-8_W7.62mm_Socket
U5: ATMEGA328P-PU; DIP-28_W7.62mm_Socket
U6: LM7805_TO220; TO-220-3_Vertical
U7, U9: 74HC595; DIP-16_W7.62mm_Socket
U8: L298D; Multiwatt15
Y1: 16MHz; Crystal_HC49-U_Vertical

Connections:
2V5: C13.1, C38.1, R6.2, R7.1, U1.3 (+), U1.5 (+); also elsewhere on the board
+5V: C3.1, C4.1, C5.1, C6.1, C9.1, C10.1, C11.1, C47.1, D1.1 (K), D2.2 (A), D3.2 (A), J3.2, J19.1, J20.6, J21.1, J22.1, R3.1, R5.1, R6.1, R20.2, R21.1, R30.2, R31.2, R34.2, R49.2, U1.8 (V+), U5.7 (VCC), U5.20 (AVCC), U6.3 (VO), U7.16 (VCC), U8.9 (Vss), U9.16 (VCC); also elsewhere on the board
+12V: C2.1, C31.1, C32.1, D2.1 (K), D6.1 (K), D8.1 (K), D10.1 (K), D12.1 (K), F1.2, U6.1 (VI), U8.4 (Vs)
CLROUT: C46.1, R21.2, U7.10 (SRCLR), U9.10 (SRCLR)
CURSEN1: R15.1, U5.23 ((PCINT8/ADC0)PC0)
CURSEN2: R13.1, U5.24 ((PCINT9/ADC1)PC1)
GND: C2.2, C3.2, C4.2, C5.2, C6.2, C7.1, C8.1, C9.2, C10.2, C11.2, C13.2, C16.1, C31.2, C32.2, C38.2, C39.2, C40.2, C44.2, C45.2, C46.2, C47.2, C50.1, C55.2, D4.2 (A), D7.2 (A), D9.2 (A), D11.2 (A), D13.2 (A), J1.2, J2.1, J3.6, J19.4, J20.1, J21.4, J22.2, MK1.1 (-), Q1.1 (E), R1.2, R4.2, R7.2, R10.1, R11.2, R12.2, R17.1, R19.1, SW1.1, U1.4 (V-), U5.8 (GND), U5.22 (GND), U6.2 (GND), U7.8 (GND), U7.13 (G), U8.8 (GND), U9.8 (GND), U9.13 (G); also elsewhere on the board
LATCH: U5.16 ((PCINT2/OC1B/~SS)PB2), U7.12 (RCLK), U9.12 (RCLK)
LIGHTLEVEL: U5.27 ((PCINT12/SDA/ADC4)PC4); also elsewhere on the board
LIGHTSELA: U9.1 (QB); also elsewhere on the board
LIGHTSELB: U9.2 (QC); also elsewhere on the board
LIGHTSELC: U9.3 (QD); also elsewhere on the board
MICOUT: R16.2, R17.2, R22.1, RV1.1, U1.7, U5.28 ((PCINT13/SCL/ADC5)PC5)
MICTHR: J3.1, R65.2, U5.18 ((PCINT4/MISO)PB4)
MOSI: J3.4, U5.17 ((PCINT3/OC2A/MOSI)PB3), U7.14 (SER)
MOTORPWM1: U5.11 ((PCINT21/OC0B/T1)PD5), U8.6 (EN_A)
MOTORPWM2: U5.12 ((PCINT22/OC0A/AIN0)PD6), U8.11 (EN_B)
MTRIN1: U7.4 (QE), U8.5 (IN_1)
MTRIN2: U7.3 (QD), U8.7 (IN_2)
MTRIN3: U7.2 (QC), U8.10 (IN_3)
MTRIN4: U7.1 (QB), U8.12 (IN_4)
unnamed: C12.2, R8.2
unnamed: C14.1, C50.2, R14.2
unnamed: C15.2, R22.2
unnamed: C49.1, R9.2, R10.2, R14.1, U1.1
unnamed: D3.1 (K), R4.1
unnamed: C15.1, D4.1 (K), D5.2 (A)
unnamed: C16.2, D5.1 (K), R18.2
unnamed: D6.2 (A), D7.1 (K), J4.1, U8.3 (OUT_2)
unnamed: D8.2 (A), D9.1 (K), J5.2, U8.13 (OUT_3)
unnamed: D10.2 (A), D11.1 (K), J4.2, U8.2 (OUT_1)
unnamed: D12.2 (A), D13.1 (K), J5.1, U8.14 (OUT_4)
unnamed: F1.1, J1.1
unnamed: J2.2, R29.2
unnamed: J2.3, R1.1, R2.1
unnamed: C1.2, J2.4
unnamed: C40.1, J19.2, R30.1, U5.4 ((PCINT18/INT0)PD2)
unnamed: C39.1, J19.3, R31.1, U5.5 ((PCINT19/OC2B/INT1)PD3)
unnamed: J20.2, U7.5 (QF)
unnamed: J20.3, U7.6 (QG)
unnamed: J20.4, U7.7 (QH)
unnamed: J20.5, U7.15 (QA)
unnamed: C45.1, J21.2, R49.1, U5.14 ((PCINT0/CLKO/ICP1)PB0)
unnamed: C44.1, J21.3, R34.1, U5.15 ((PCINT1/OC1A)PB1)
unnamed: C12.1, MK1.2 (+), R5.2
unnamed: Q1.2 (B), R18.1, R19.2
unnamed: Q1.3 (C), R20.1, R65.1
unnamed: C49.2, R8.1, R9.1, U1.2 (-)
unnamed: C14.2, R16.1, RV1.2, RV1.3, U1.6 (-)
unnamed: C7.2, U5.9 ((PCINT6/XTAL1/TOSC1)PB6), Y1.2
unnamed: C8.2, U5.10 ((PCINT7/XTAL2/TOSC2)PB7), Y1.1
unnamed: C55.1, U5.21 (AREF)
unnamed: U7.9 (~QH), U9.14 (SER)
unnamed: R11.1, R15.2, U8.1 (Current_Sensing_A)
unnamed: R12.1, R13.2, U8.15 (Current_Sensing_B)
PHOTLEVELOUT: U5.25 ((PCINT10/ADC2)PC2); also elsewhere on the board
PHOTSELA: U9.4 (QE); also elsewhere on the board
PHOTSELB: U9.5 (QF); also elsewhere on the board
PHOTSELC: U9.6 (QG); also elsewhere on the board
PHOTSELON: U9.7 (QH); also elsewhere on the board
RESET: C1.1, D1.2 (A), J3.5, R3.2, SW1.2, U5.1 ((PCINT14/~RESET)PC6)
RXD: R29.1, U5.2 ((PCINT16/RXD)PD0)
SCK: J3.3, U5.19 ((PCINT5/SCK)PB5), U7.11 (SRCLK), U9.11 (SRCLK)
TXD: R2.2, U5.3 ((PCINT17/TXD)PD1)
ULTRASOUNDOUT: U5.26 ((PCINT11/ADC3)PC3); also elsewhere on the board
ULTRASOUNDTHR: U5.6 ((PCINT20/XCK/T0)PD4); also elsewhere on the board
ULTRATRANS: U5.13 ((PCINT23/AIN1)PD7); also elsewhere on the board

Notes on the sheet:
Arduino Robot Control Board by Daniel Marks CC-BY-SA 4.0
