profdc9/NiftyRobot/ControlBoard/ControlBoard.kicad_pcb

## KiCad design ControlBoard/ControlBoard.kicad_pcb (continued)

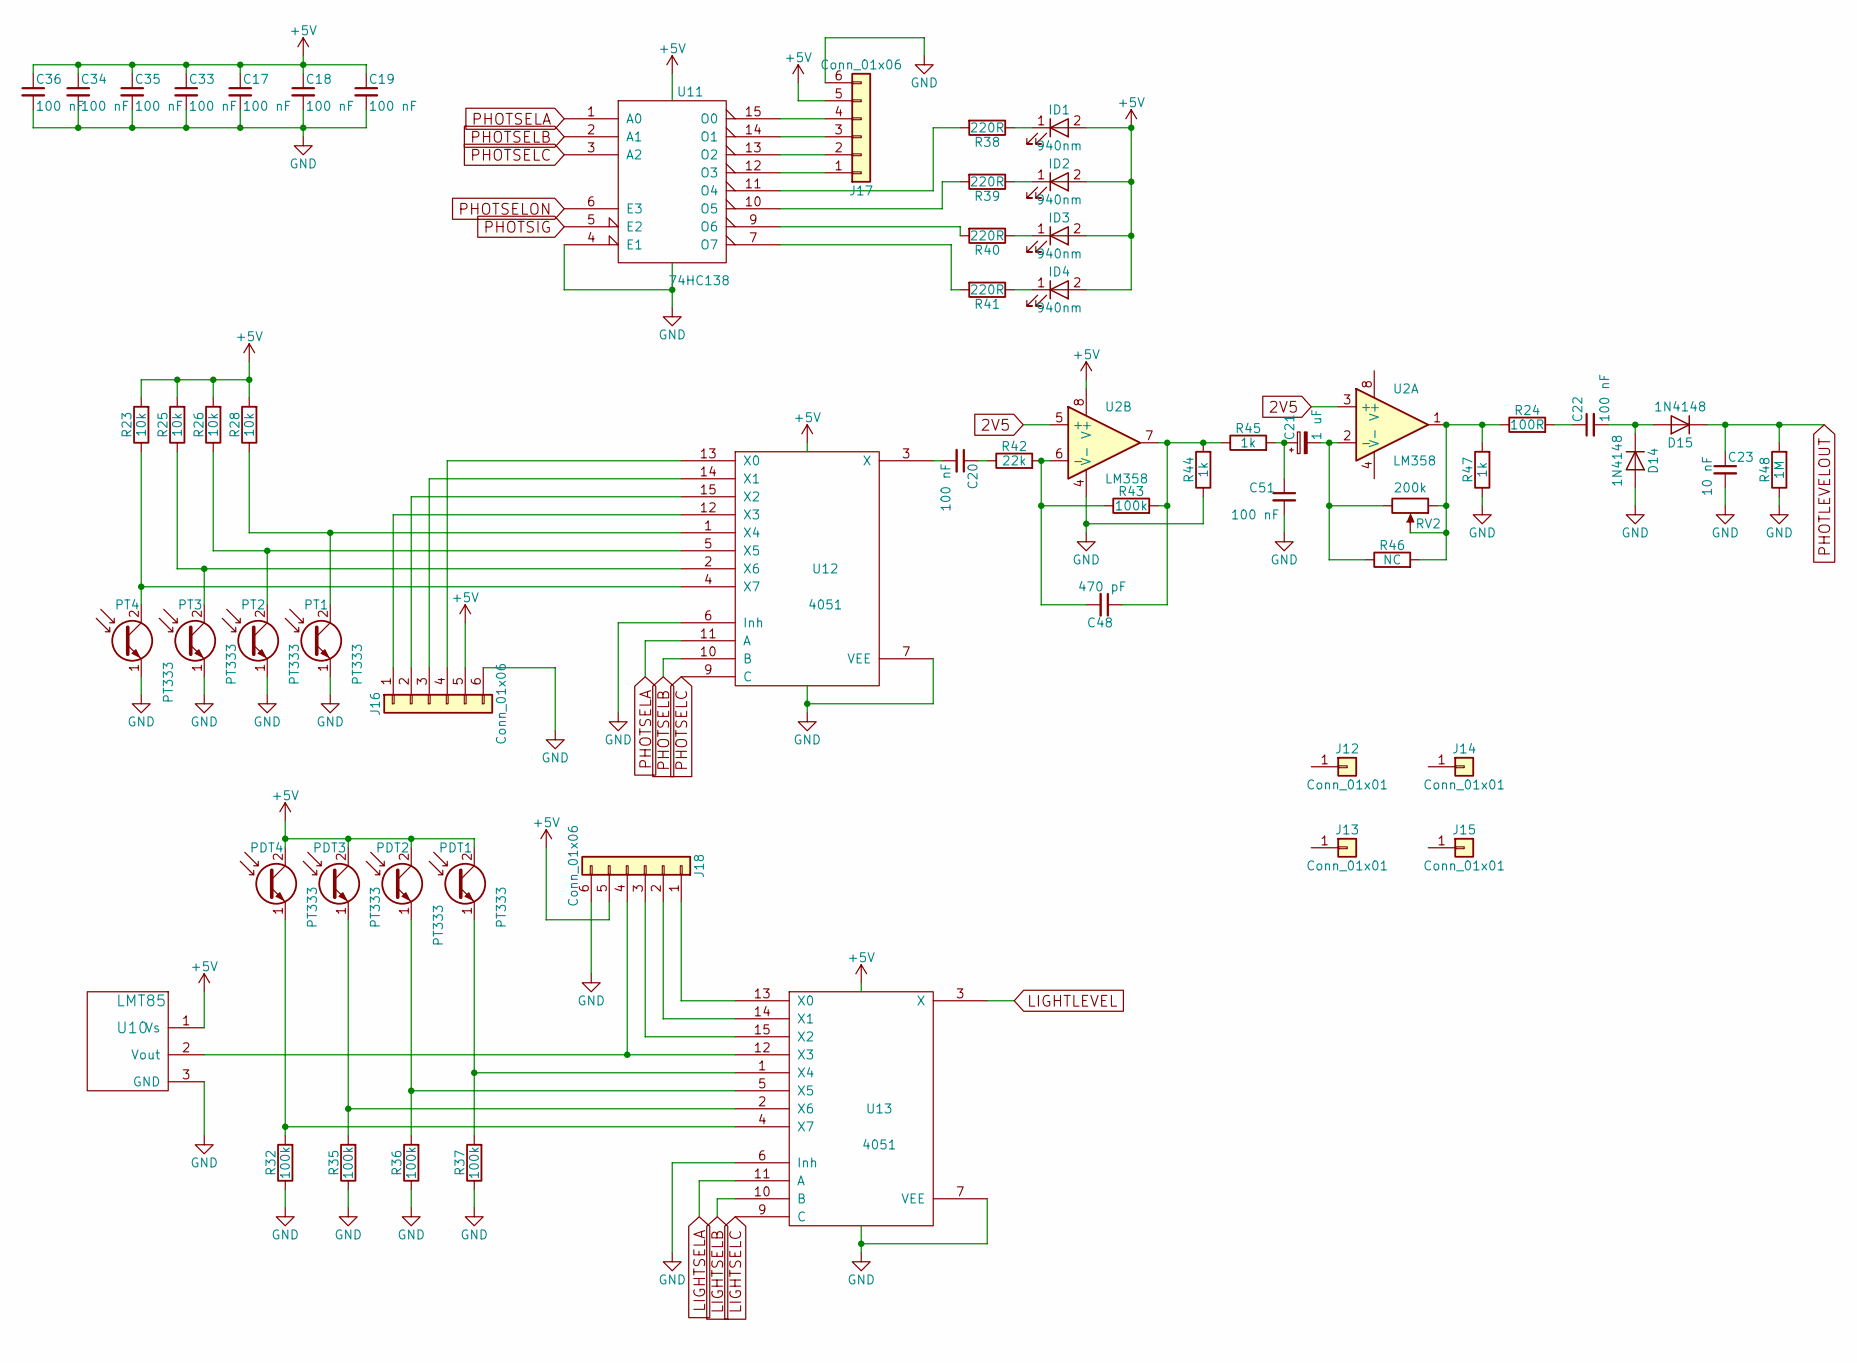
[picture p33: schematic PhotoSensors.kicad_sch]

Parts:
C17, C18, C19, C33, C34, C35, C36: 100 nF; C_Disc_D5.0mm_W2.5mm_P2.50mm
C20, C22, C51: 100 nF; C_Disc_D5.0mm_W2.5mm_P5.00mm
C21: 1 uF; CP_Radial_D5.0mm_P2.50mm
C23: 10 nF; C_Disc_D5.0mm_W2.5mm_P5.00mm
C48: 470 pF; C_Disc_D5.0mm_W2.5mm_P5.00mm
D14, D15: 1N4148; D_DO-41_SOD81_P7.62mm_Horizontal
ID1, ID2, ID3, ID4: 940nm; LED_D5.0mm
J12, J13, J14, J15: Conn_01x01; IRPair
J16, J17, J18: Conn_01x06; Pin_Header_Straight_1x06_Pitch2.54mm
PDT1, PDT2, PDT3, PDT4: PT333; LED_D5.0mm
PT1, PT2, PT3, PT4: PT333; LED_D5.0mm
R23, R25, R26, R28: 10k; R_Axial_DIN0207_L6.3mm_D2.5mm_P7.62mm_Horizontal
R24: 100R; R_Axial_DIN0207_L6.3mm_D2.5mm_P7.62mm_Horizontal
R32, R35, R36, R37, R43: 100k; R_Axial_DIN0207_L6.3mm_D2.5mm_P7.62mm_Horizontal
R38, R39, R40, R41: 220R; R_Axial_DIN0207_L6.3mm_D2.5mm_P7.62mm_Horizontal
R42: 22k; R_Axial_DIN0207_L6.3mm_D2.5mm_P7.62mm_Horizontal
R44, R45, R47: 1k; R_Axial_DIN0207_L6.3mm_D2.5mm_P7.62mm_Horizontal
R46: NC; R_Axial_DIN0207_L6.3mm_D2.5mm_P7.62mm_Horizontal
R48: 1M; R_Axial_DIN0207_L6.3mm_D2.5mm_P7.62mm_Horizontal
RV2: 200k; Potentiometer_Trimmer_Bourns_3296W
U2: LM358; DIP-8_W7.62mm_Socket
U10: LMT85; TO-92_Inline_Wide
U11: 74HC138; DIP-16_W7.62mm_Socket
U12, U13: 4051; DIP-16_W7.62mm_Socket

Connections:
2V5: U2.3 (+), U2.5 (+); also elsewhere on the board
+5V: C17.1, C18.1, C19.1, C33.1, C34.1, C35.1, C36.1, ID1.2 (A), ID2.2 (A), ID3.2 (A), ID4.2 (A), J16.5, J17.5, J18.5, PDT1.2 (C), PDT2.2 (C), PDT3.2 (C), PDT4.2 (C), R23.2, R25.2, R26.2, R28.2, U2.8 (V+), U10.1 (Vs), U11.16 (VCC), U12.16 (VDD), U13.16 (VDD); also elsewhere on the board
GND: C17.2, C18.2, C19.2, C23.2, C33.2, C34.2, C35.2, C36.2, C51.2, D14.2 (A), J16.6, J17.6, J18.6, PT1.1 (E), PT2.1 (E), PT3.1 (E), PT4.1 (E), R32.1, R35.1, R36.1, R37.1, R44.1, R47.1, R48.1, U2.4 (V-), U10.3 (GND), U11.4 (E1), U11.8 (GND), U12.6 (Inh), U12.7 (VEE), U12.8 (VSS), U13.6 (Inh), U13.7 (VEE), U13.8 (VSS); also elsewhere on the board
LIGHTLEVEL: U13.3 (X); also elsewhere on the board
LIGHTSELA: U13.11 (A); also elsewhere on the board
LIGHTSELB: U13.10 (B); also elsewhere on the board
LIGHTSELC: U13.9 (C); also elsewhere on the board
unnamed: C20.1, R42.1
unnamed: C21.1, C51.1, R45.2
unnamed: C22.1, R24.2
unnamed: C48.1, R43.2, R44.2, R45.1, U2.7
unnamed: C22.2, D14.1 (K), D15.2 (A)
unnamed: ID1.1 (K), R38.1
unnamed: ID2.1 (K), R39.1
unnamed: ID3.1 (K), R40.1
unnamed: ID4.1 (K), R41.1
unnamed: J16.1, U12.12 (X3)
unnamed: J16.2, U12.15 (X2)
unnamed: J16.3, U12.14 (X1)
unnamed: J16.4, U12.13 (X0)
unnamed: J17.1, U11.12 (O3)
unnamed: J17.2, U11.13 (O2)
unnamed: J17.3, U11.14 (O1)
unnamed: J17.4, U11.15 (O0)
unnamed: J18.1, U13.13 (X0)
unnamed: J18.2, U13.14 (X1)
unnamed: J18.3, U13.15 (X2)
unnamed: J18.4, U10.2 (Vout), U13.12 (X3)
unnamed: PDT1.1 (E), R37.2, U13.1 (X4)
unnamed: PDT2.1 (E), R36.2, U13.5 (X5)
unnamed: PDT3.1 (E), R35.2, U13.2 (X6)
unnamed: PDT4.1 (E), R32.2, U13.4 (X7)
unnamed: PT1.2 (C), R28.1, U12.1 (X4)
unnamed: PT2.2 (C), R26.1, U12.5 (X5)
unnamed: PT3.2 (C), R25.1, U12.2 (X6)
unnamed: PT4.2 (C), R23.1, U12.4 (X7)
unnamed: R24.1, R46.2, R47.2, RV2.1, RV2.2, U2.1
unnamed: C21.2, R46.1, RV2.3, U2.2 (-)
unnamed: C48.2, R42.2, R43.1, U2.6 (-)
unnamed: R38.2, U11.11 (O4)
unnamed: R39.2, U11.10 (O5)
unnamed: R40.2, U11.9 (O6)
unnamed: R41.2, U11.7 (O7)
unnamed: C20.2, U12.3 (X)
PHOTLEVELOUT: C23.1, D15.1 (K), R48.2; also elsewhere on the board
PHOTSELA: U11.1 (A0), U12.11 (A); also elsewhere on the board
PHOTSELB: U11.2 (A1), U12.10 (B); also elsewhere on the board
PHOTSELC: U11.3 (A2), U12.9 (C); also elsewhere on the board
PHOTSELON: U11.6 (E3); also elsewhere on the board
PHOTSIG: U11.5 (E2); also elsewhere on the board

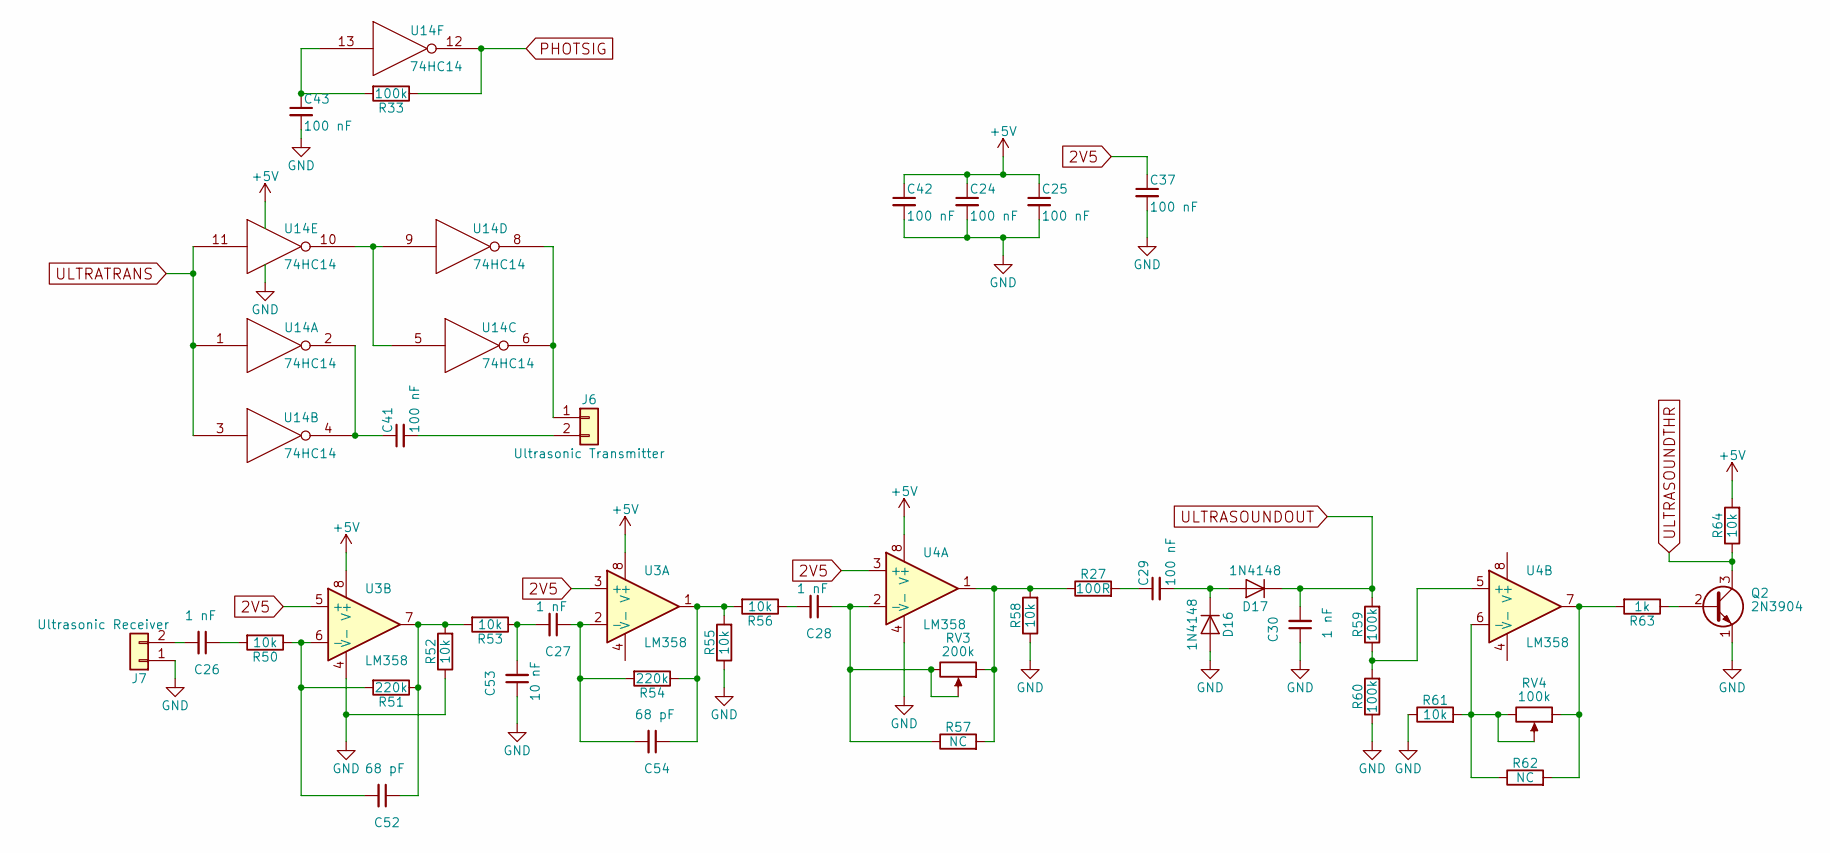
[picture p34: schematic UltrasonicSensor.kicad_sch]

Parts:
C24, C25, C29, C37, C41, C42, C43: 100 nF; C_Disc_D5.0mm_W2.5mm_P2.50mm
C26, C27, C28, C30: 1 nF; C_Disc_D5.0mm_W2.5mm_P5.00mm
C52, C54: 68 pF; C_Disc_D5.0mm_W2.5mm_P5.00mm
C53: 10 nF; C_Disc_D5.0mm_W2.5mm_P5.00mm
D16, D17: 1N4148; D_DO-41_SOD81_P7.62mm_Horizontal
J6: Ultrasonic Transmitter; TerminalBlock_bornier-2_P5.08mm
J7: Ultrasonic Receiver; TerminalBlock_bornier-2_P5.08mm
Q2: 2N3904; TO-92_Inline_Wide
R27: 100R; R_Axial_DIN0207_L6.3mm_D2.5mm_P7.62mm_Horizontal
R33, R59, R60: 100k; R_Axial_DIN0207_L6.3mm_D2.5mm_P7.62mm_Horizontal
R50, R52, R53, R55, R56, R58, R61, R64: 10k; R_Axial_DIN0207_L6.3mm_D2.5mm_P7.62mm_Horizontal
R51, R54: 220k; R_Axial_DIN0207_L6.3mm_D2.5mm_P7.62mm_Horizontal
R57, R62: NC; R_Axial_DIN0207_L6.3mm_D2.5mm_P7.62mm_Horizontal
R63: 1k; R_Axial_DIN0207_L6.3mm_D2.5mm_P7.62mm_Horizontal
RV3: 200k; Potentiometer_Trimmer_Bourns_3296W
RV4: 100k; Potentiometer_Trimmer_Bourns_3296W
U3, U4: LM358; DIP-8_W7.62mm_Socket
U14: 74HC14; DIP-14_W7.62mm_Socket

Connections:
2V5: C37.1, U3.3 (+), U3.5 (+), U4.3 (+); also elsewhere on the board
+5V: C24.1, C25.1, C42.1, R64.2, U3.8 (V+), U4.8 (V+), U14.14 (VCC); also elsewhere on the board
GND: C24.2, C25.2, C30.1, C37.2, C42.2, C43.2, C53.1, D16.2 (A), J7.1, Q2.1 (E), R52.1, R55.1, R58.1, R60.1, R61.1, U3.4 (V-), U4.4 (V-), U14.7 (GND); also elsewhere on the board
unnamed: C26.1, R50.2
unnamed: C27.2, C53.2, R53.1
unnamed: C28.2, R56.1
unnamed: C29.1, R27.2
unnamed: C41.1, U14.2, U14.4
unnamed: C43.1, R33.2, U14.13
unnamed: C52.1, R51.1, R52.2, R53.2, U3.7
unnamed: C54.1, R54.1, R55.2, R56.2, U3.1
unnamed: C29.2, D16.1 (K), D17.2 (A)
unnamed: J6.1, U14.6, U14.8
unnamed: C41.2, J6.2
unnamed: C26.2, J7.2
unnamed: Q2.2 (B), R63.1
unnamed: R27.1, R57.2, R58.2, RV3.1, U4.1
unnamed: R62.2, R63.2, RV4.1, U4.7
unnamed: C27.1, C54.2, R54.2, U3.2 (-)
unnamed: C52.2, R50.1, R51.2, U3.6 (-)
unnamed: C28.1, R57.1, RV3.2, RV3.3, U4.2 (-)
unnamed: R59.1, R60.2, U4.5 (+)
unnamed: R61.2, R62.1, RV4.2, RV4.3, U4.6 (-)
unnamed: U14.5, U14.9, U14.10
PHOTSIG: R33.1, U14.12; also elsewhere on the board
ULTRASOUNDOUT: C30.2, D17.1 (K), R59.2; also elsewhere on the board
ULTRASOUNDTHR: Q2.3 (C), R64.1; also elsewhere on the board
ULTRATRANS: U14.1, U14.3, U14.11; also elsewhere on the board

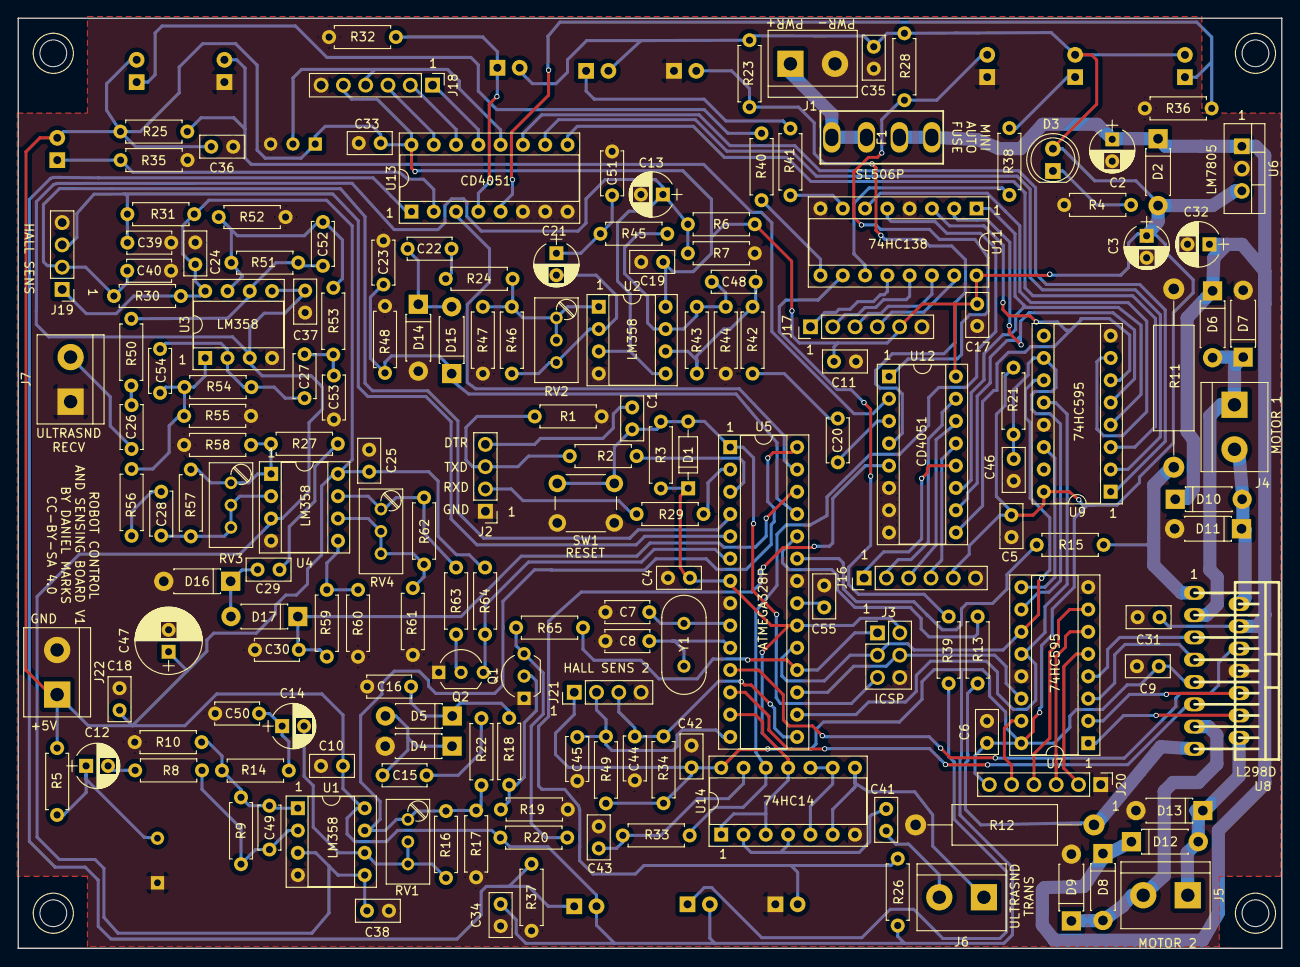
[picture p35: board ControlBoard.kicad_pcb from above]

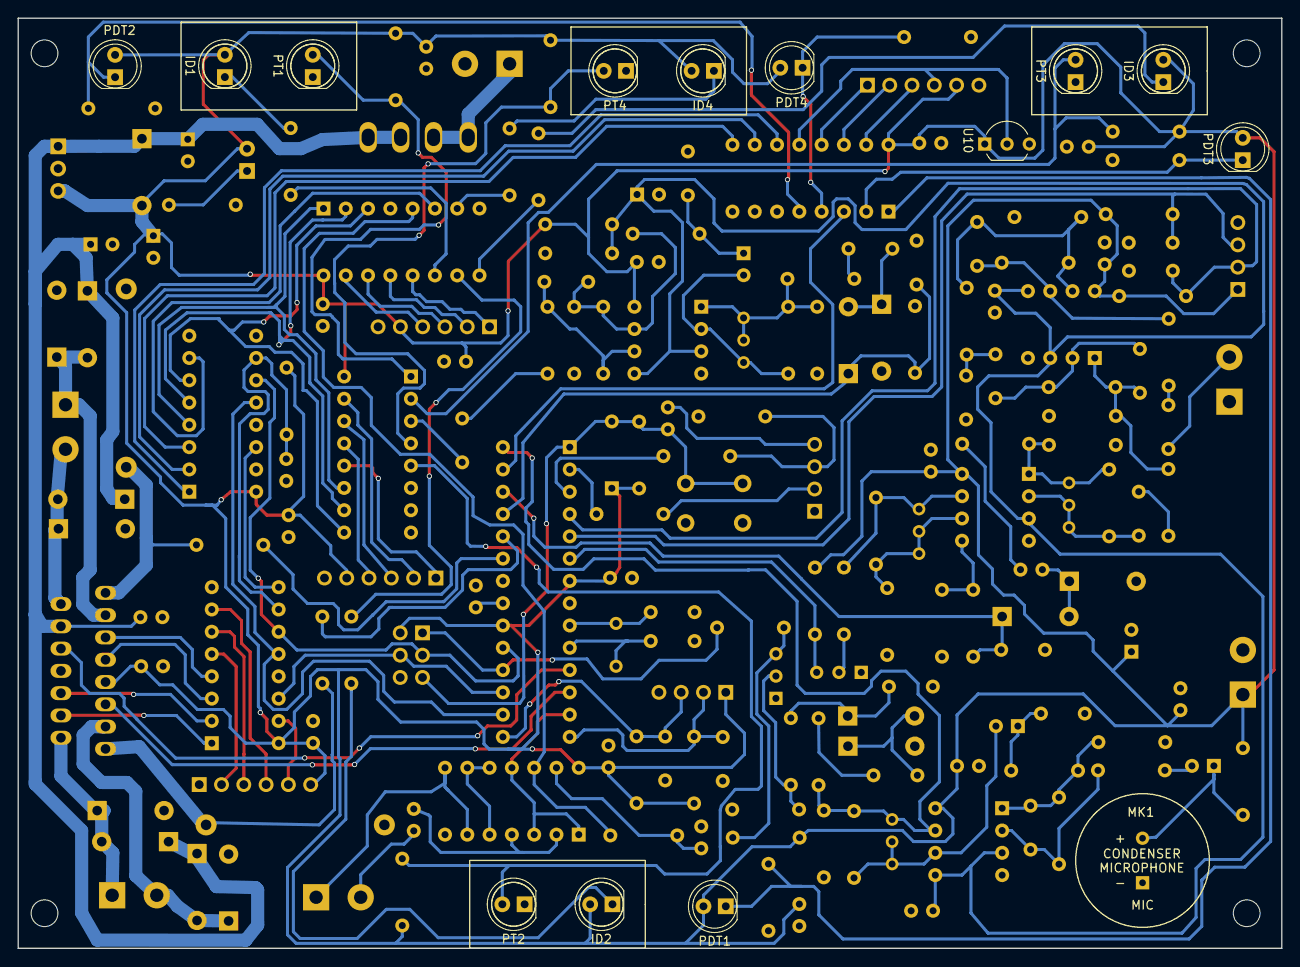
[picture p36: board ControlBoard.kicad_pcb from below]

Board: 2 copper layers, 144.0 x 106.0 mm, 195 parts (18 on the bottom side), 126 nets.
