profdc9/NiftyRobot/KeypadPI/KeypadPI.kicad_pcb

## KiCad design KeypadPI/KeypadPI.kicad_pcb (2025-10-23)

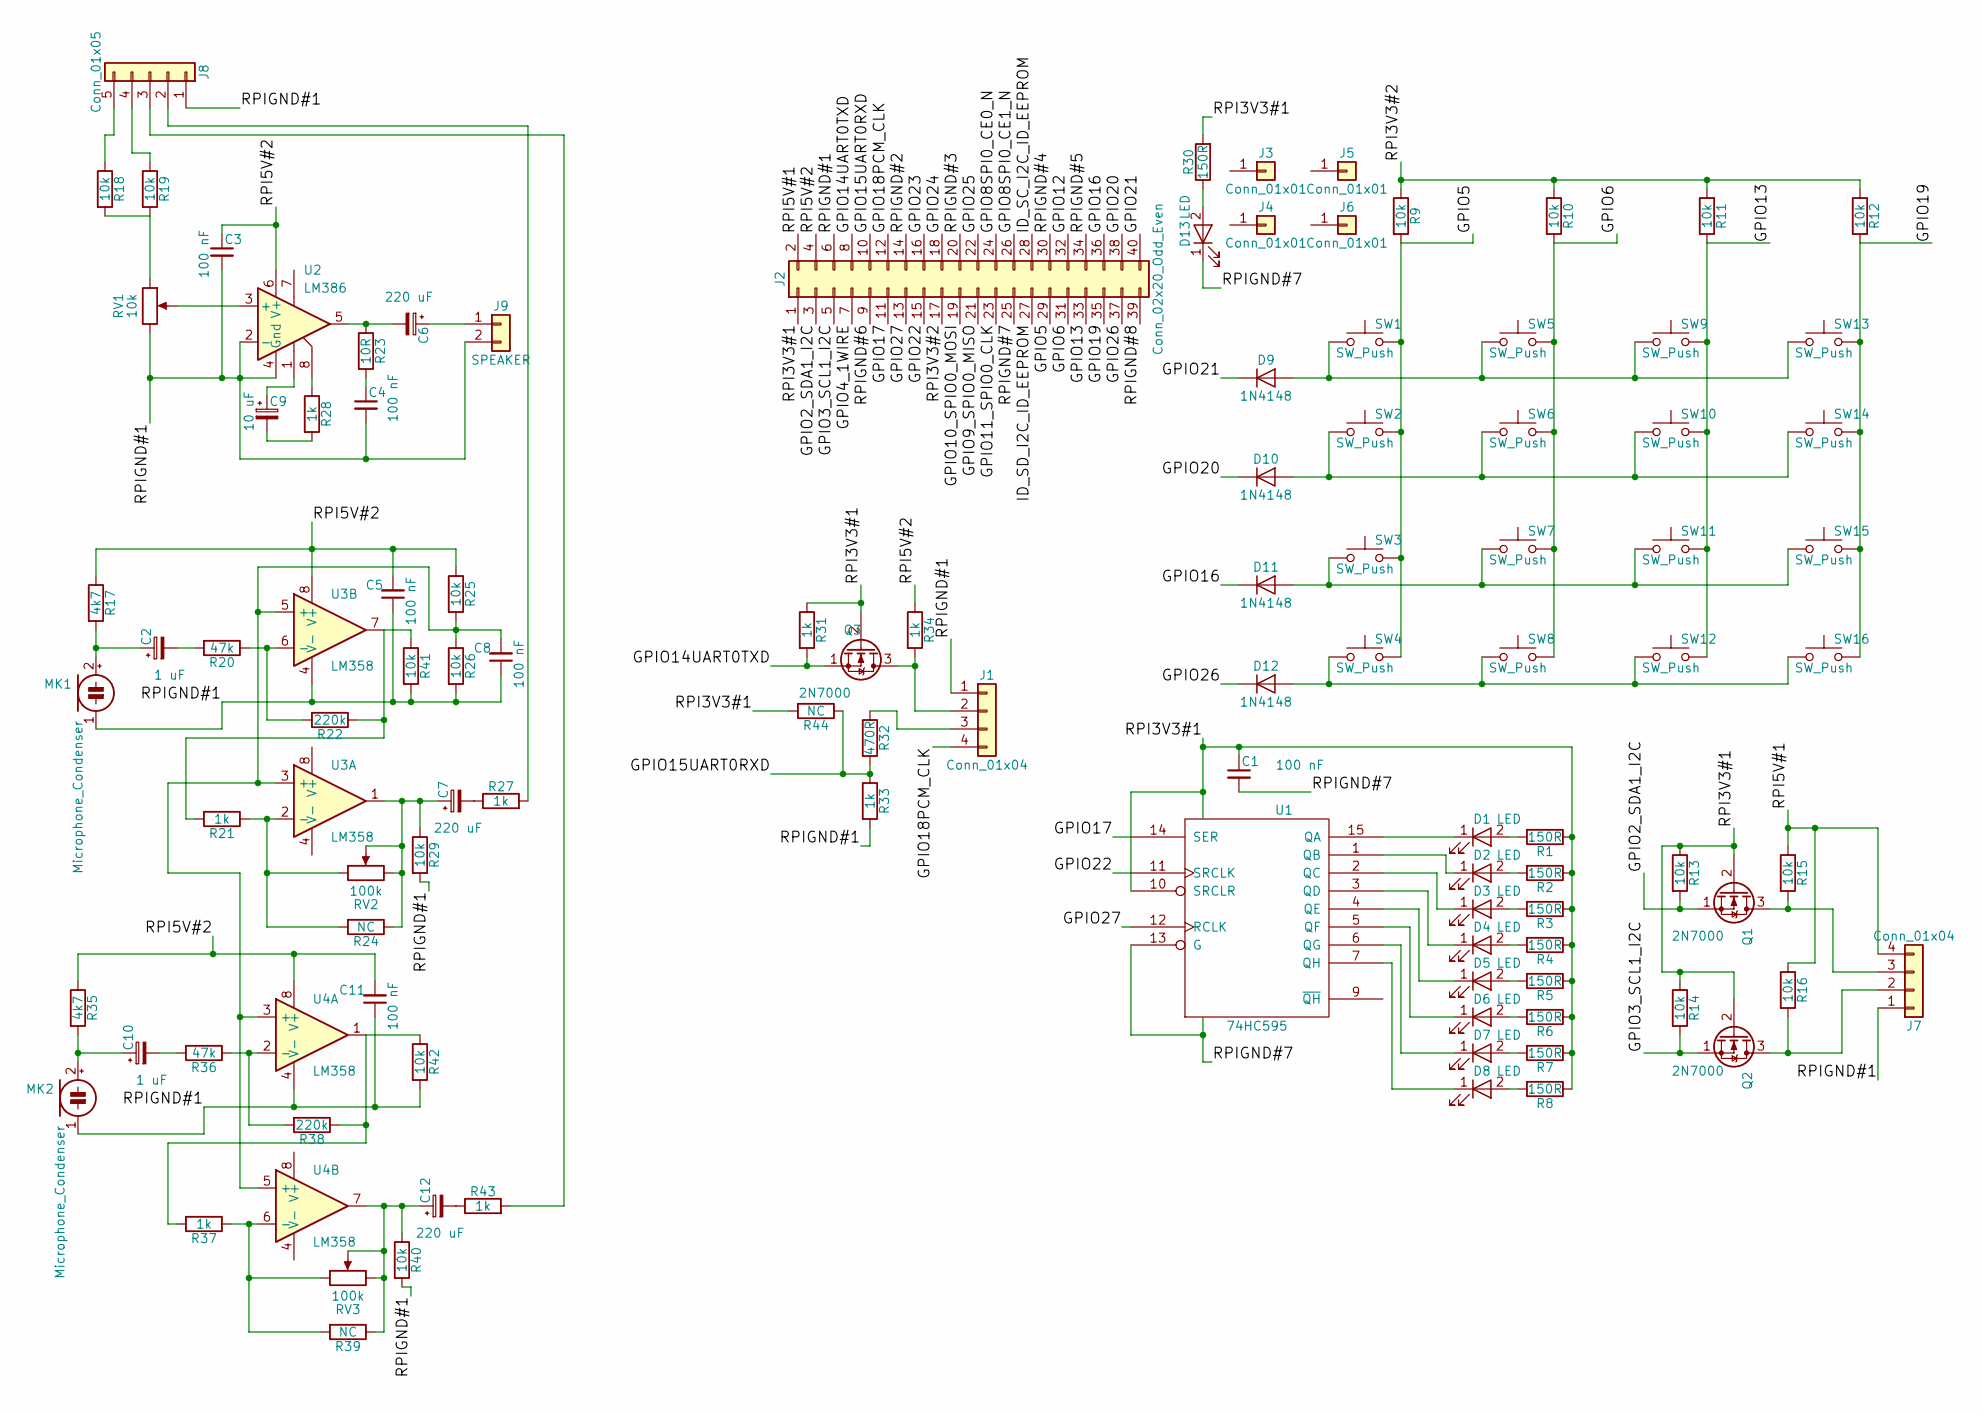
[picture p37: schematic KeypadPI.sch]

Parts:
C1, C3, C4, C5, C8, C11: 100 nF; C_Disc_D5.0mm_W2.5mm_P2.50mm
C2, C10: 1 uF; CP_Radial_D5.0mm_P2.50mm
C6, C7, C12: 220 uF; CP_Radial_D5.0mm_P2.50mm
C9: 10 uF; CP_Radial_D5.0mm_P2.50mm
D1, D2, D3, D4, D5, D6, D7, D8, D13: LED; LED_D5.0mm
D9, D10, D11, D12: 1N4148; D_DO-35_SOD27_P7.62mm_Horizontal
J1, J7: Conn_01x04; Pin_Header_Straight_1x04_Pitch2.54mm
J2: Conn_02x20_Odd_Even; Pin_Header_Straight_2x20_Pitch2.54mm
J3, J4, J5, J6: Conn_01x01; 1pin
J8: Conn_01x05; Pin_Header_Straight_1x05_Pitch2.54mm
J9: SPEAKER; TerminalBlock_bornier-2_P5.08mm
MK1, MK2: Microphone_Condenser; CondenserMic
Q1, Q2, Q3: 2N7000; TO-92_Inline_Wide
R1, R2, R3, R4, R5, R6, R7, R8, R30: 150R; R_Axial_DIN0207_L6.3mm_D2.5mm_P7.62mm_Horizontal
R9, R10, R11, R12, R13, R14, R15, R16, R18, R19, R25, R26, R29, R40, R41, R42: 10k; R_Axial_DIN0207_L6.3mm_D2.5mm_P7.62mm_Horizontal
R17, R35: 4k7; R_Axial_DIN0207_L6.3mm_D2.5mm_P7.62mm_Horizontal
R20, R36: 47k; R_Axial_DIN0207_L6.3mm_D2.5mm_P7.62mm_Horizontal
R21, R27, R28, R31, R33, R34, R37, R43: 1k; R_Axial_DIN0207_L6.3mm_D2.5mm_P7.62mm_Horizontal
R22, R38: 220k; R_Axial_DIN0207_L6.3mm_D2.5mm_P7.62mm_Horizontal
R23: 10R; R_Axial_DIN0207_L6.3mm_D2.5mm_P7.62mm_Horizontal
R24, R39, R44: NC; R_Axial_DIN0207_L6.3mm_D2.5mm_P7.62mm_Horizontal
R32: 470R; R_Axial_DIN0207_L6.3mm_D2.5mm_P7.62mm_Horizontal
RV1: 10k; Potentiometer_Trimmer_Bourns_3296W
RV2, RV3: 100k; Potentiometer_Trimmer_Bourns_3296W
SW1, SW2, SW3, SW4, SW5, SW6, SW7, SW8, SW9, SW10, SW11, SW12, SW13, SW14, SW15, SW16: SW_Push; SW_PUSH_6mm
U1: 74HC595; DIP-16_W7.62mm_Socket
U2: LM386; DIP-8_W7.62mm_Socket
U3, U4: LM358; DIP-8_W7.62mm_Socket

Connections:
/GPIO2_SDA1_I2C: J2.3, Q1.1 (S), R13.2
/GPIO3_SCL1_I2C: J2.5, Q2.1 (S), R14.2
/GPIO4_1WIRE: J2.7
/GPIO5: J2.29, R9.2, SW1.2, SW2.2, SW3.2, SW4.2
/GPIO6: J2.31, R10.2, SW5.2, SW6.2, SW7.2, SW8.2
/GPIO8SPI0_CE0_N: J2.24
/GPIO8SPI0_CE1_N: J2.26
/GPIO9_SPIO0_MISO: J2.21
/GPIO10_SPIO0_MOSI: J2.19
/GPIO11_SPIO0_CLK: J2.23
/GPIO12: J2.32
/GPIO13: J2.33, R11.2, SW9.2, SW10.2, SW11.2, SW12.2
/GPIO14UART0TXD: J2.8, Q3.1 (S), R31.2
/GPIO15UART0RXD: J2.10, R32.2, R33.1, R44.1
/GPIO16: D11.1 (K), J2.36
/GPIO17: J2.11, U1.14 (SER)
/GPIO18PCM_CLK: J1.4, J2.12
/GPIO19: J2.35, R12.2, SW13.2, SW14.2, SW15.2, SW16.2
/GPIO20: D10.1 (K), J2.38
/GPIO21: D9.1 (K), J2.40
/GPIO22: J2.15, U1.11 (SRCLK)
/GPIO23: J2.16
/GPIO24: J2.18
/GPIO25: J2.22
/GPIO26: D12.1 (K), J2.37
/GPIO27: J2.13, U1.12 (RCLK)
/ID_SC_I2C_ID_EEPROM: J2.28
/ID_SD_I2C_ID_EEPROM: J2.27
/RPI3V3#2: J2.17, R9.1, R10.1, R11.1, R12.1
/RPI5V#1: J2.2, J7.4, R15.1, R16.1
/RPI5V#2: C3.1, C5.2, C11.2, J2.4, R17.1, R25.1, R34.1, R35.1, U2.6 (V+), U3.8 (V+), U4.8 (V+)
/RPIGND#1: C3.2, C4.2, C5.1, C8.1, C11.1, J1.1, J2.6, J7.1, J8.1, J9.2, MK1.1 (-), MK2.1 (-), R26.2, R29.2, R33.2, R40.2, R41.2, R42.2, RV1.3, U2.2 (-), U2.4 (Gnd), U3.4 (V-), U4.4 (V-)
/RPIGND#2: J2.14
/RPIGND#3: J2.20
/RPIGND#4: J2.30
/RPIGND#5: J2.34
/RPIGND#6: J2.9
/RPIGND#8: J2.39
GND: C1.2, D13.1 (K), J2.25, U1.8 (GND), U1.13 (G)
unnamed: C2.1, MK1.2 (+), R17.2
unnamed: C2.2, R20.2
unnamed: C4.1, R23.2
unnamed: C6.1, J9.1
unnamed: C6.2, R23.1, U2.5
unnamed: C7.1, R24.1, R29.1, RV2.2, RV2.3, U3.1
unnamed: C7.2, R27.1
unnamed: C8.2, R25.2, R26.1, U3.3 (+), U3.5 (+), U4.3 (+), U4.5 (+)
unnamed: C9.1, U2.1
unnamed: C9.2, R28.2
unnamed: C10.1, MK2.2 (+), R35.2
unnamed: C10.2, R36.2
unnamed: C12.1, R39.1, R40.1, RV3.2, RV3.3, U4.7
unnamed: C12.2, R43.1
unnamed: D1.1 (K), U1.15 (QA)
unnamed: D1.2 (A), R1.2
unnamed: D2.1 (K), U1.1 (QB)
unnamed: D2.2 (A), R2.2
unnamed: D3.1 (K), U1.2 (QC)
unnamed: D3.2 (A), R3.2
unnamed: D4.1 (K), U1.3 (QD)
unnamed: D4.2 (A), R4.2
unnamed: D5.1 (K), U1.4 (QE)
unnamed: D5.2 (A), R5.2
unnamed: D6.1 (K), U1.5 (QF)
unnamed: D6.2 (A), R6.2
unnamed: D7.1 (K), U1.6 (QG)
unnamed: D7.2 (A), R7.2
unnamed: D8.1 (K), U1.7 (QH)
unnamed: D8.2 (A), R8.2
unnamed: D9.2 (A), SW1.1, SW5.1, SW9.1, SW13.1
unnamed: D10.2 (A), SW2.1, SW6.1, SW10.1, SW14.1
unnamed: D11.2 (A), SW3.1, SW7.1, SW11.1, SW15.1
unnamed: D12.2 (A), SW4.1, SW8.1, SW12.1, SW16.1
unnamed: D13.2 (A), R30.1
unnamed: J1.2, Q3.3 (D), R34.2
unnamed: J1.3, R32.1
unnamed: J7.2, Q2.3 (D), R16.2
unnamed: J7.3, Q1.3 (D), R15.2
unnamed: J8.2, R27.2
unnamed: J8.3, R43.2
unnamed: J8.4, R19.1
unnamed: J8.5, R18.1
unnamed: R18.2, R19.2, RV1.1
unnamed: R20.1, R22.2, U3.6 (-)
unnamed: R21.1, R24.2, RV2.1, U3.2 (-)
unnamed: R21.2, R22.1, R41.1, U3.7
unnamed: R28.1, U2.8
unnamed: R36.1, R38.2, U4.2 (-)
unnamed: R37.1, R39.2, RV3.1, U4.6 (-)
unnamed: R37.2, R38.1, R42.1, U4.1
unnamed: RV1.2, U2.3 (+)
VCC: C1.1, J2.1, Q1.2 (G), Q2.2 (G), Q3.2 (G), R1.1, R2.1, R3.1, R4.1, R5.1, R6.1, R7.1, R8.1, R13.1, R14.1, R30.2, R31.1, R44.2, U1.10 (SRCLR), U1.16 (VCC)

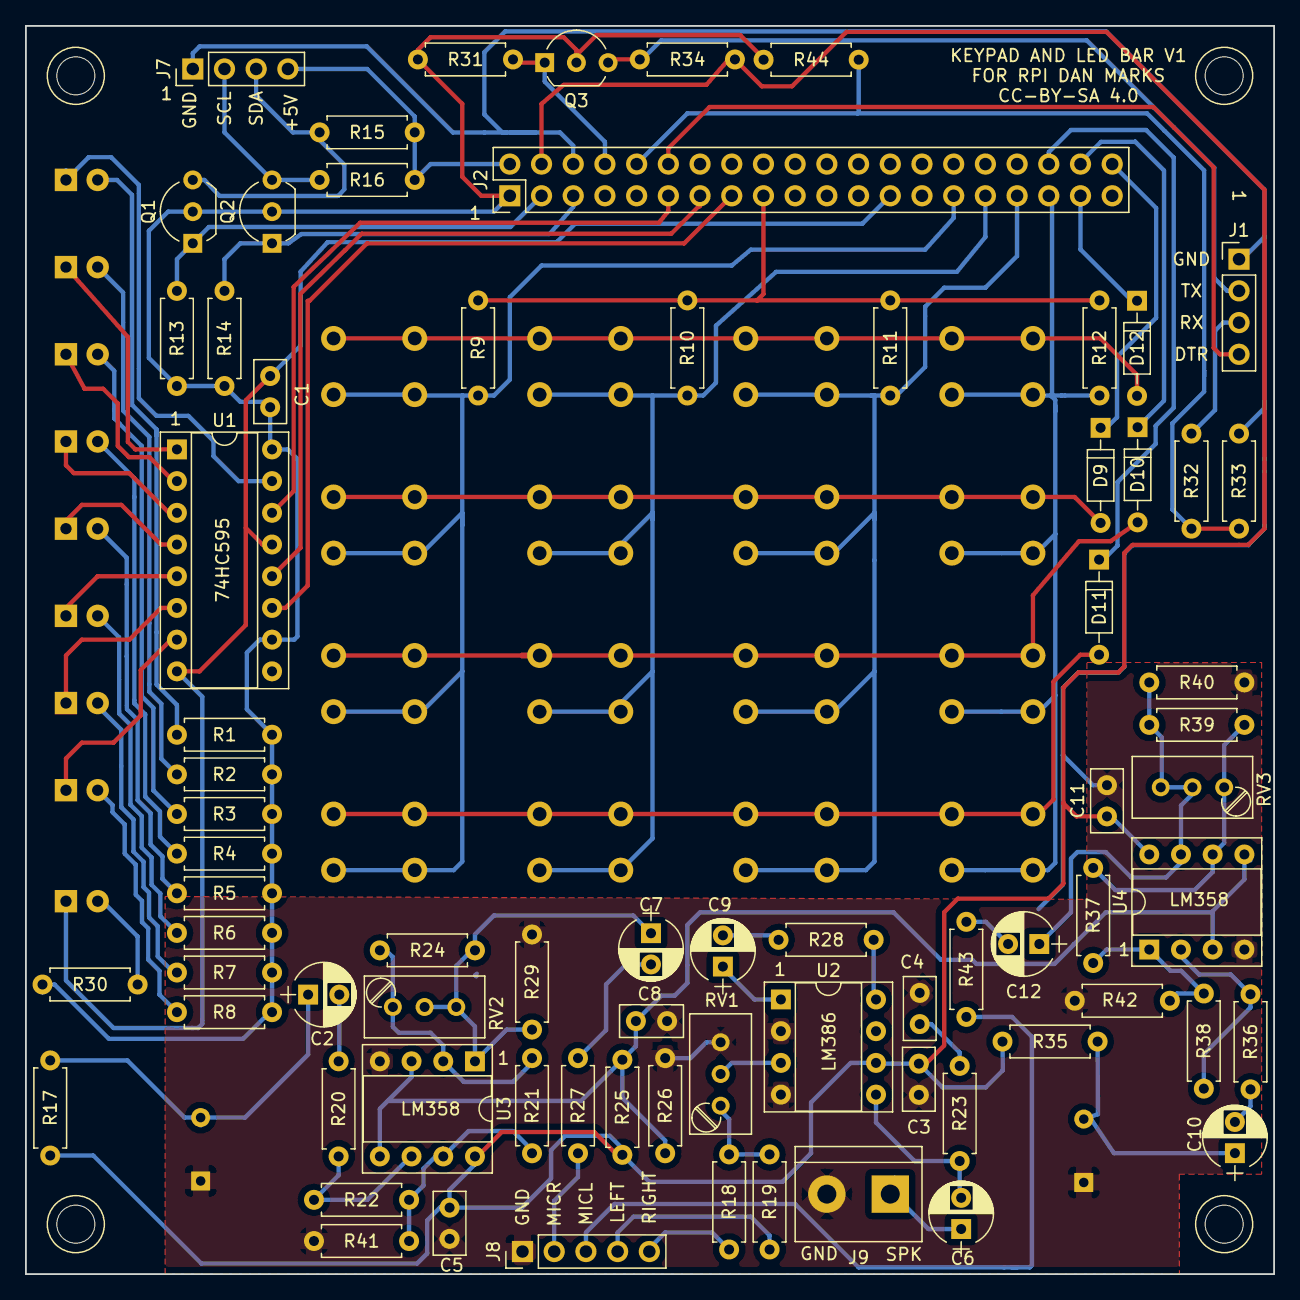
[picture p38: board KeypadPI.kicad_pcb from above]

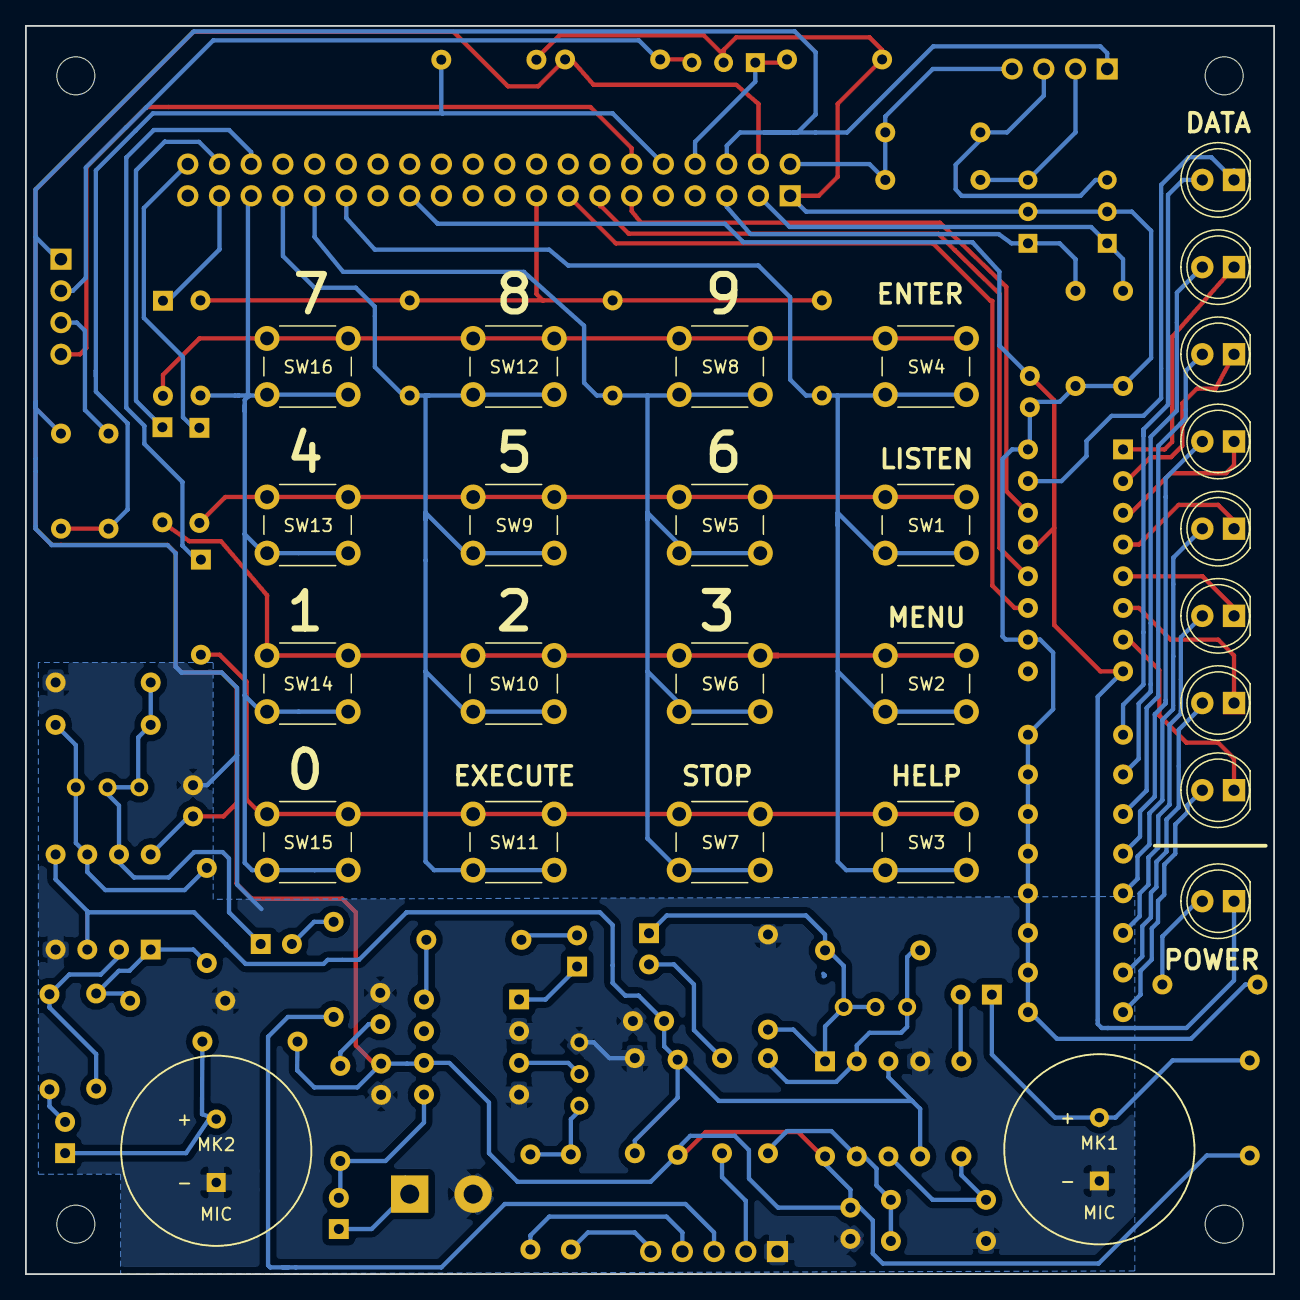
[picture p39: board KeypadPI.kicad_pcb from below]

Board: 2 copper layers, 100.0 x 100.0 mm, 106 parts (27 on the bottom side), 74 nets.
