profdc9/NiftyRobot/(commit log)

2021-09-24 Added CAD models
    [AdapterBoard-B.Cu.gbr, AdapterBoard-B.Mask.gbr, AdapterBoard-B.SilkS.gbr, AdapterBoard-Edge.Cuts.gbr, AdapterBoard-F.Cu.gbr, AdapterBoard-F.Mask.gbr, AdapterBoard-F.SilkS.gbr, AdapterBoard-NPTH.drl]
2021-09-25 Added KeypadPI
    [ControlBoard-B.Cu.gbr, ControlBoard-B.Mask.gbr, ControlBoard-B.SilkS.gbr, ControlBoard-Edge.Cuts.gbr, ControlBoard-F.Cu.gbr, ControlBoard-F.Mask.gbr, ControlBoard-F.SilkS.gbr, ControlBoard-NPTH.drl]
2021-09-26 Added audio input and output to keypad PCB
    [ControlBoard-B.Cu.gbr, ControlBoard-B.Mask.gbr, ControlBoard-B.SilkS.gbr, ControlBoard-Edge.Cuts.gbr, ControlBoard-F.Cu.gbr, ControlBoard-F.Mask.gbr, ControlBoard-F.SilkS.gbr, ControlBoard-NPTH.drl]
2021-09-26 Added second microphone to keypad
    [AdapterBoard-B.Cu.gbr, AdapterBoard-B.Mask.gbr, AdapterBoard-B.SilkS.gbr, AdapterBoard-Edge.Cuts.gbr, AdapterBoard-F.Cu.gbr, AdapterBoard-F.Mask.gbr, AdapterBoard-F.SilkS.gbr, AdapterBoard-NPTH.drl]
2021-09-27 A few fixes
    [ControlBoard-B.Cu.gbr, ControlBoard-B.Mask.gbr, ControlBoard-B.SilkS.gbr, ControlBoard-Edge.Cuts.gbr, ControlBoard-F.Cu.gbr, ControlBoard-F.Mask.gbr, ControlBoard-F.SilkS.gbr, ControlBoard-NPTH.drl]
2021-10-04 JLCPCB order 2021-10-03
    [ControlBoard-B.Cu.gbr, ControlBoard-B.Mask.gbr, ControlBoard-B.SilkS.gbr, ControlBoard-Edge.Cuts.gbr, ControlBoard-F.Cu.gbr, ControlBoard-F.Mask.gbr, ControlBoard-F.SilkS.gbr, ControlBoard-NPTH.drl]
2021-10-10 Added CAD files
    [BackPanel-BackPanelBody.stl, BackPanel.FCStd, BackPanel2.FCStd, BackPanel2.stl, DiagonalLeftPanel-DiagonalLeftPanel.stl, DiagonalLeftPanel.FCStd, DiagonalLeftPanel2.stl, DiagonalRightPanel-DiagonalRightPanel.stl]
2021-11-20 Begin code for controlling robot with command line
    [ControlBoard-B.Cu.gbr, ControlBoard-B.Mask.gbr, ControlBoard-B.SilkS.gbr, ControlBoard-Edge.Cuts.gbr, ControlBoard-F.Cu.gbr, ControlBoard-F.Mask.gbr, ControlBoard-F.SilkS.gbr, ControlBoard-NPTH.drl]
2022-01-11 Added some filter capacitors
    [ControlBoard-B.Cu.gbr, ControlBoard-B.Mask.gbr, ControlBoard-B.SilkS.gbr, ControlBoard-Edge.Cuts.gbr, ControlBoard-F.Cu.gbr, ControlBoard-F.Mask.gbr, ControlBoard-F.SilkS.gbr, ControlBoard-NPTH.drl]
2022-01-12 Added capacitor for AREF
    [ControlBoard-B.Cu.gbr, ControlBoard-B.Mask.gbr, ControlBoard-B.SilkS.gbr, ControlBoard-Edge.Cuts.gbr, ControlBoard-F.Cu.gbr, ControlBoard-F.Mask.gbr, ControlBoard-F.SilkS.gbr, ControlBoard-NPTH.drl]
2025-10-23 new commit
    [AdapterBoard-2025-02-02-21-03-59.sch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]
2026-02-07 Added experimental ultrasonic phased array
    [AdapterBoard-2025-02-02-21-03-59.sch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]
